1002380/soturonn/README.md

# 卒業論文
 [本文](https://github.com/1002380/soturonn/blob/main/%E8%B3%87%E6%96%99/%E6%9C%AC%E7%A8%BF_%E7%B4%B0%E5%B7%9D%E8%92%BC%E7%94%9F.pdf)
 
 [作成したプログラム](https://github.com/1002380/soturonn/blob/main/%E8%B3%87%E6%96%99/ble_thermo.ino)

 進捗報告書
  - 目次
    - [progress01](https://github.com/1002380/soturonn/blob/main/%E8%B3%87%E6%96%99/progress01.md) アップロードのテスト
    - [progress02](https://github.com/1002380/soturonn/blob/main/%E8%B3%87%E6%96%99/progress02.md) 春休みまでに考えていたことのまとめ
    - [progress03](https://github.com/1002380/soturonn/blob/main/%E8%B3%87%E6%96%99/progress03.md) 研究内容の整理
    - [progress04](https://github.com/1002380/soturonn/blob/main/%E8%B3%87%E6%96%99/progress04.md) 電波から電気を取り出す練習
    - [progress05](https://github.com/1002380/soturonn/blob/main/%E8%B3%87%E6%96%99/progress05.md) 平滑回路の実験
    - [progress06](https://github.com/1002380/soturonn/blob/main/%E8%B3%87%E6%96%99/progress06.md) LEDの点灯実験
    - [progress07](https://github.com/1002380/soturonn/blob/main/%E8%B3%87%E6%96%99/progress07.md) 安定化回路の作成
    - [progress08](https://github.com/1002380/soturonn/blob/main/%E8%B3%87%E6%96%99/progress08.md) 変圧回路の実験
    - [progress09](https://github.com/1002380/soturonn/blob/main/%E8%B3%87%E6%96%99/progress09.md) オシロスコープの影響の調査
    - [progress10](https://github.com/1002380/soturonn/blob/main/%E8%B3%87%E6%96%99/progress10.md) アンテナの設計
    - [progress11](https://github.com/1002380/soturonn/blob/main/%E8%B3%87%E6%96%99/progress11.md) アンテナの作成実験 
    - [progress12](https://github.com/1002380/soturonn/blob/main/%E8%B3%87%E6%96%99/progress12.md) 複数巻きループアンテナの実験
    - [progress13](https://github.com/1002380/soturonn/blob/main/%E8%B3%87%E6%96%99/progress13.md) ラジオ用アンテナの実験
    - [progress14](https://github.com/1002380/soturonn/blob/main/%E8%B3%87%E6%96%99/progress14.md) ダイポールアンテナの実験
    - [progress15](https://github.com/1002380/soturonn/blob/main/%E8%B3%87%E6%96%99/progress15.md) AMラジオ塔での実験
    - [progress16](https://github.com/1002380/soturonn/blob/main/%E8%B3%87%E6%96%99/progress16.md) 充電用回路の改造
    - [progress17](https://github.com/1002380/soturonn/blob/main/%E8%B3%87%E6%96%99/progress17.md) 機材の注文
    - [progress18](https://github.com/1002380/soturonn/blob/main/%E8%B3%87%E6%96%99/progress18.md) 電磁波によるバッテリ充電
    - [progress19](https://github.com/1002380/soturonn/blob/main/%E8%B3%87%E6%96%99/progress19.md) 作る電子機器の構想
    - [progress20](https://github.com/1002380/soturonn/blob/main/%E8%B3%87%E6%96%99/progress20.md) アンテナの改良
    - [progress21](https://github.com/1002380/soturonn/blob/main/%E8%B3%87%E6%96%99/progress21.md) 電子機器の開発
    - [progress22](https://github.com/1002380/soturonn/blob/main/%E8%B3%87%E6%96%99/progress22.md) ディープスリープモードの実装
    - [progress23](https://github.com/1002380/soturonn/blob/main/%E8%B3%87%E6%96%99/progress23.md) データ保存の実装
    - [progress24](https://github.com/1002380/soturonn/blob/main/%E8%B3%87%E6%96%99/progress24.md) プログラムの修正
