1002380/soturonn/資料/README.md

# 卒業論文
 本文(https://github.com/1002380/soturonn/資料/本稿_細川蒼生.pdf)

 作成したプログラム(https://github.com/1002380/soturonn/資料/ble_thermo.ino)

 進捗報告書
  - 目次
    - progress01(https://github.com/1002380/soturonn/資料/progress01.md) アップロードのテスト
    - progress02(https://github.com/1002380/soturonn/資料/progress02.md) 春休みまでに考えていたことのまとめ
    - progress03(https://github.com/1002380/soturonn/資料/progress03.md) 研究内容の整理
    - progress04(https://github.com/1002380/soturonn/資料/progress04.md) 電波から電気を取り出す練習
    - progress05(https://github.com/1002380/soturonn/資料/progress05.md) 平滑回路の実験
    - progress06(https://github.com/1002380/soturonn/資料/progress06.md) LEDの点灯実験
    - progress07(https://github.com/1002380/soturonn/資料/progress07.md) 安定化回路の作成
    - progress08(https://github.com/1002380/soturonn/資料/progress08.md) 変圧回路の実験
    - progress09(https://github.com/1002380/soturonn/資料/progress09.md) オシロスコープの影響の調査
    - progress10(https://github.com/1002380/soturonn/資料/progress10.md) アンテナの設計
    - progress11(https://github.com/1002380/soturonn/資料/progress11.md) アンテナの作成実験 
    - progress12(https://github.com/1002380/soturonn/資料/progress12.md) 複数巻きループアンテナの実験
    - progress13(https://github.com/1002380/soturonn/資料/progress13.md) ラジオ用アンテナの実験
    - progress04(https://github.com/1002380/soturonn/資料/progress04.md) 電波から電気を取り出す練習
    - progress05(https://github.com/1002380/soturonn/資料/progress05.md) 平滑回路の実験
    - progress06(https://github.com/1002380/soturonn/資料/progress06.md) LEDの点灯実験
    - progress07(https://github.com/1002380/soturonn/資料/progress07.md) 安定化回路の作成
    - progress08(https://github.com/1002380/soturonn/資料/progress08.md) 変圧回路の実験
    - progress09(https://github.com/1002380/soturonn/資料/progress09.md) オシロスコープの影響の調査
    - progress10(https://github.com/1002380/soturonn/資料/progress10.md) アンテナの設計
    - progress11(https://github.com/1002380/soturonn/資料/progress11.md) アンテナの作成実験
    - progress12(https://github.com/1002380/soturonn/資料/progress12.md) 複数巻きループアンテナの実験
    - progress13(https://github.com/1002380/soturonn/資料/progress13.md) ラジオ用アンテナの実験
    - progress14(https://github.com/1002380/soturonn/資料/progress13.md) ラジオ用アンテナの実験
