1002380/soturonn/資料/progress11.md

# 進捗報告書

報告書番号 | 氏名   | 期間         | 報告日
----- | ---- | ---------- | ---
11    | HosokawaAoi | 6/7 ~ 6/28 | 6/28

## 活動概要

- やったこと
  - 1回巻きループアンテナ、ダイポールアンテナの作成
  - ループアンテナと検波回路の実験
  - 測定位置による電圧の変化の調査
  - ダイポールアンテナによる実験
<br />

### アンテナの作成
  - 今回は1回巻きループアンテナとダイポールアンテナを作成した。
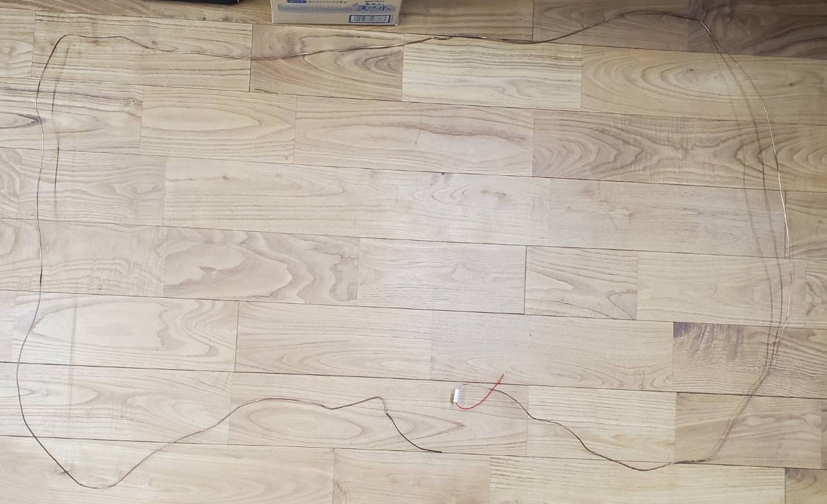
[picture p153: 資料/画像/画像11/画像11_1.jpg]
画像1
  - 
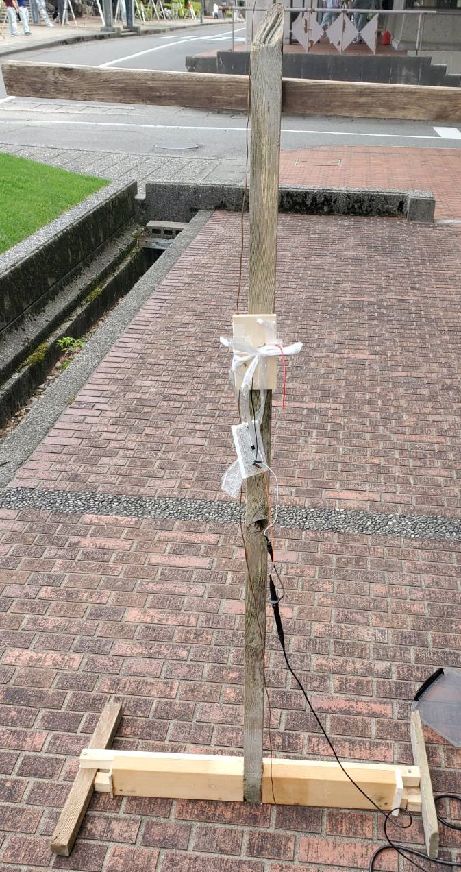
[picture p154: 資料/画像/画像11/画像11_16.jpg]
画像16
  - 
  - 回路
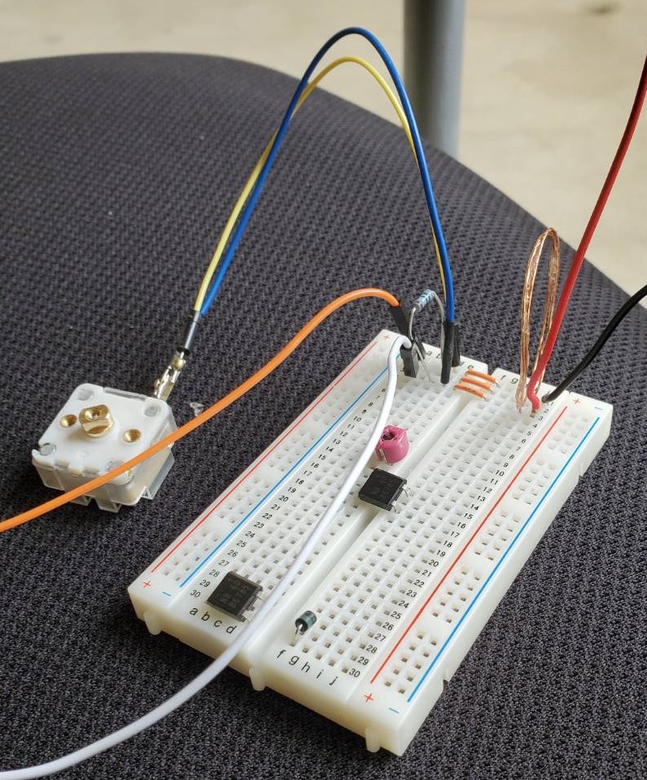
[picture p155: 資料/画像/画像11/画像11_2.jpg]
画像2
  - 
  - 今回の実験では途中まで洋服掛けをアンテナの台座として使用したが、今後のことも考慮して専用の台座を作成した。
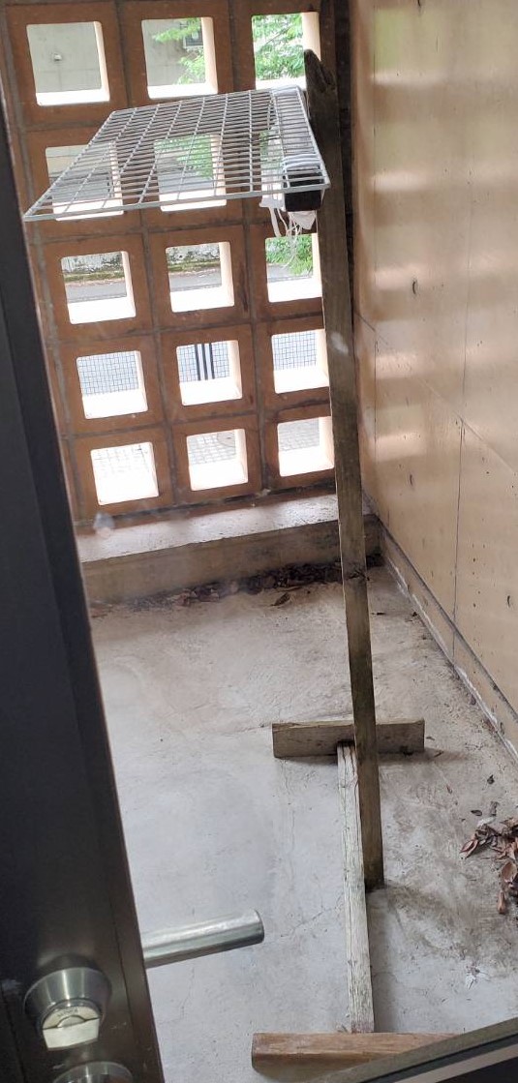
[picture p156: 資料/画像/画像11/画像11_3.jpg]
画像3
  - 

### 検波回路の実験
- 研究室での実験
  - 可変容量コンデンサの静電容量を最小の状態から上げていったところ次の波形が確認された。
  - 静電容量が最小の状態
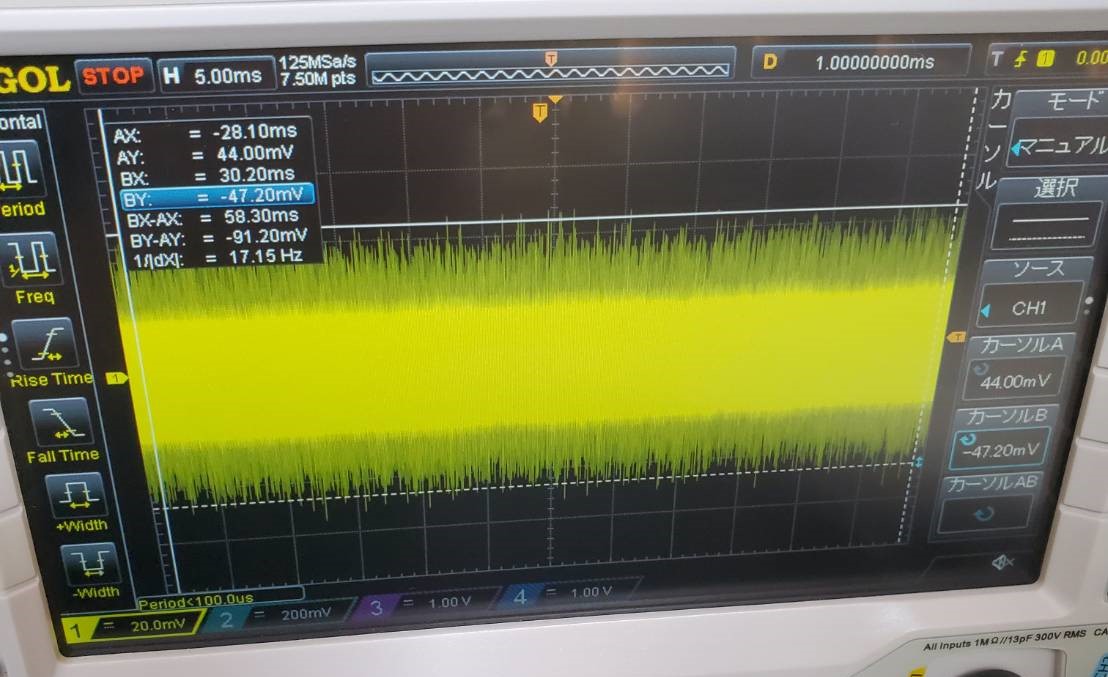
[picture p157: 資料/画像/画像11/画像11_4.jpg]
画像4
  - 
  - +-45mV
  - 電圧が最大となった状態
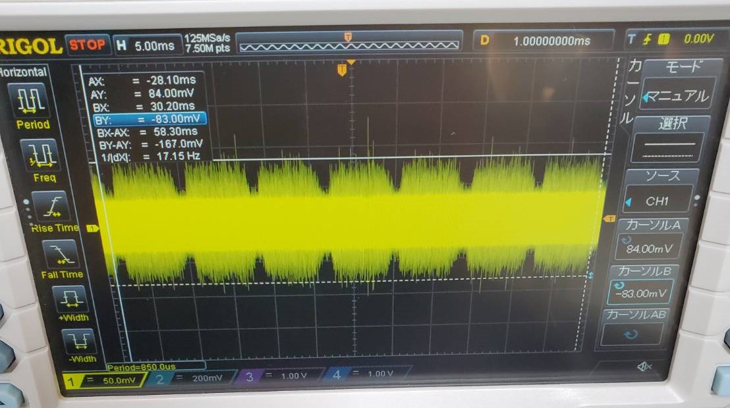
[picture p158: 資料/画像/画像11/画像11_5.jpg]
画像5
  - 
  - +-80mV
  - 電圧が最小となった状態
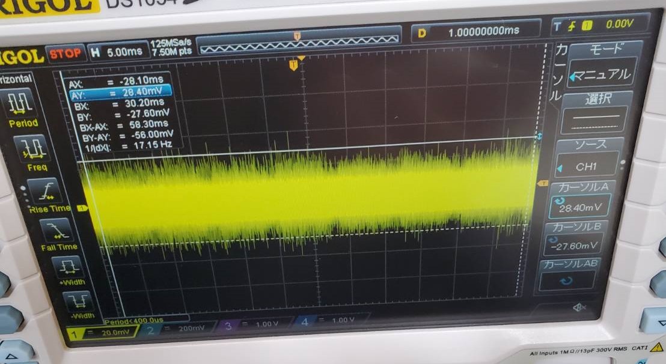
[picture p159: 資料/画像/画像11/画像11_6.jpg]
画像6
  - 
  - +-30mV
  - 電圧が最小からやや増えた状態
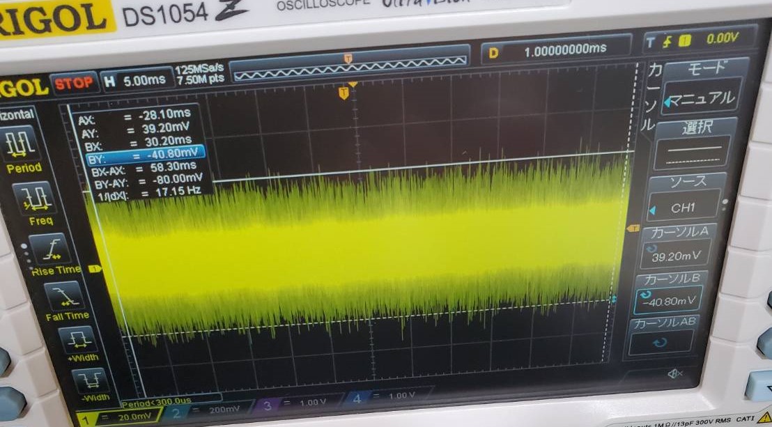
[picture p160: 資料/画像/画像11/画像11_7.jpg]
画像7
  - 
  - +-40mV
  - 静電容量が最大の状態
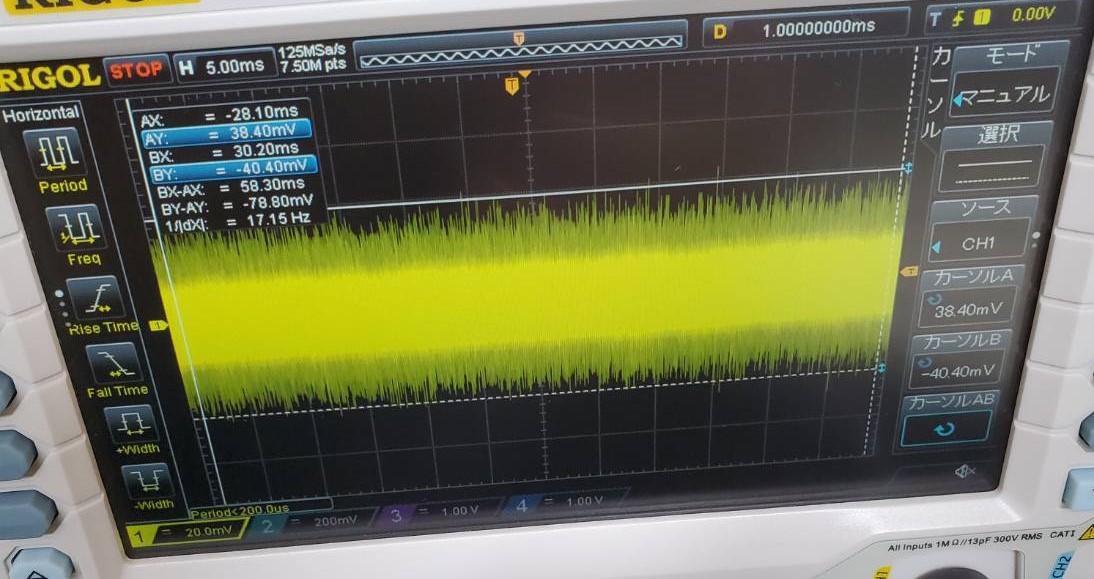
[picture p161: 資料/画像/画像11/画像11_8.jpg]
画像8
  - 
  - +-40mV
  - コンデンサの静電容量次第で電圧が60mV程度変化することが分かった。
  - 静電容量に電圧(抵抗値)が反比例していないので、恐らく共振に抵抗の変化も生じていると考えられる。(静電容量の抵抗値は1/(2π*周波数*静電容量))
  - 検波回路のコンデンサは5pFから20pFまで静電容量を変更可能であり、10pFで目的のラジオ局の電波と共振するように検波回路を作成したので、電圧が最大になった状態が、利用するラジオ局の電波であると予想する
  
- 屋外での実験
  - 研究室の実験と同様に静電容量を徐々に上げていった。
  - 静電容量が最小の状態
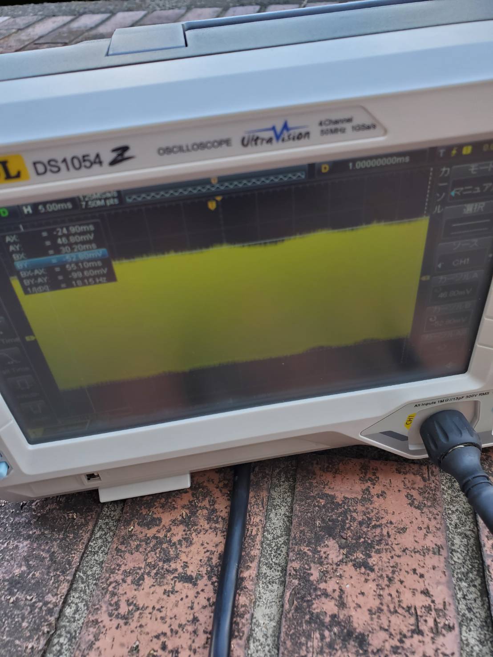
[picture p162: 資料/画像/画像11/画像11_27.jpg]
画像27
  - 
  - +-50mV
  - 電圧が最大となった状態
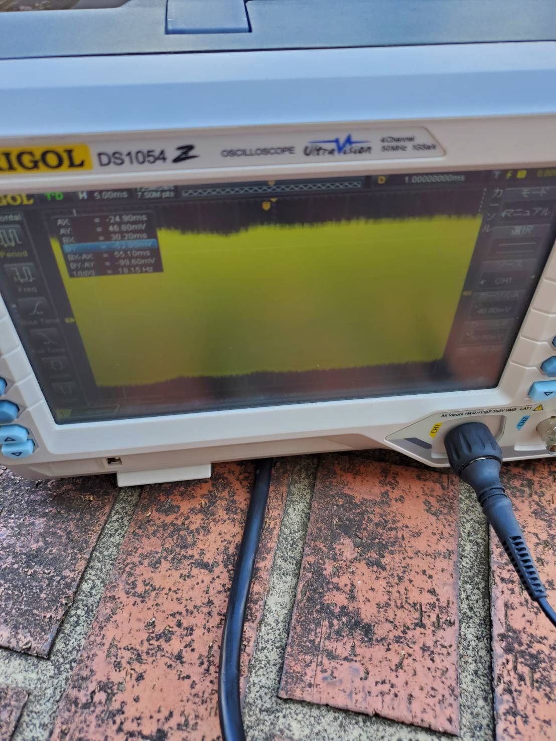
[picture p163: 資料/画像/画像11/画像11_28.jpg]
画像28
  - 
  - +-80mV
  - 電圧が最小となった状態
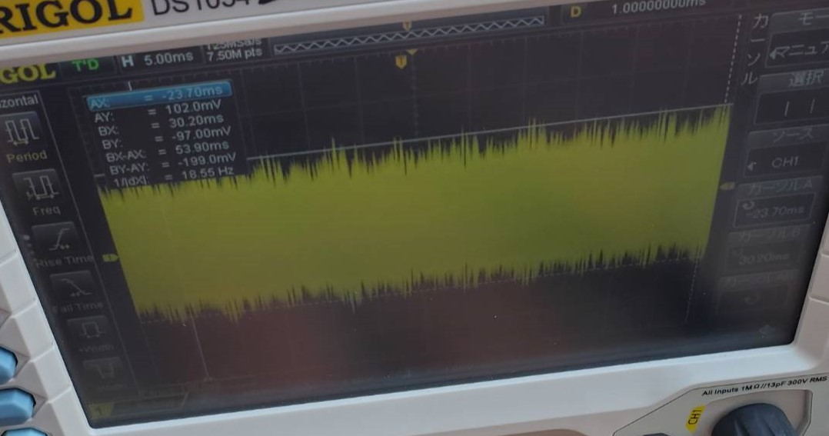
[picture p164: 資料/画像/画像11/画像11_28.5.jpg]
画像28.5
  - 
  - +-25mV
  - 電圧が最小からやや増えた状態
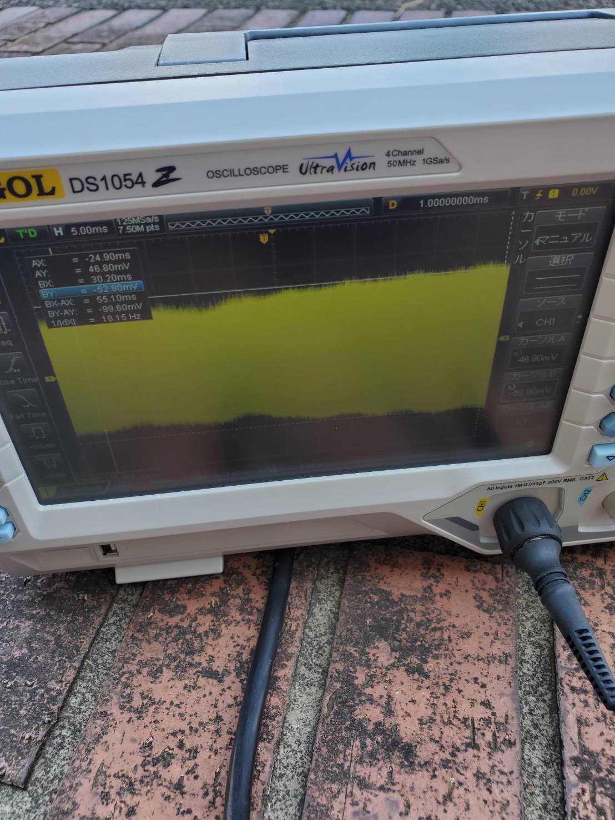
[picture p165: 資料/画像/画像11/画像11_29.jpg]
画像29
  - 
  - +-50mV
  - 静電容量が最大の状態
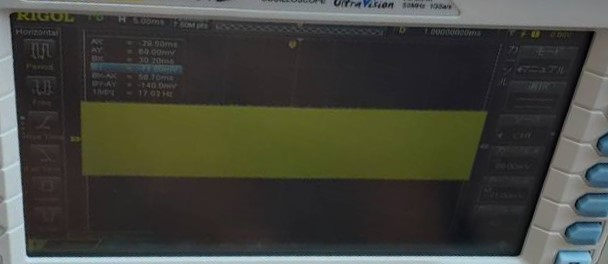
[picture p166: 資料/画像/画像11/画像11_30.jpg]
画像30
  - 
  - +-65mV
  - 実験室内の記録との比較
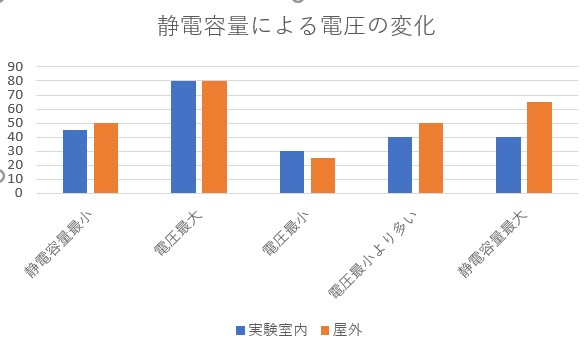
[picture p167: 資料/画像/画像11/グラフ11_1.jpg]
グラフ1
  - 
  - 研究室での結果と比較すると全体的に得られる電圧の増減のしかたや最大値と最小値に大きな差はない。
  - しかし波形を比べると屋外の方が測定値とした値を出す頻度が高く時間あたりの平均値なら高くなっていると考えられる。
  - 2種類の場所で近い静電容量の時に電圧が最大になることから利用するラジオ局の電波であると考えられる。
  - 以降の実験では測定場所が同じもしくは近い場所で既に検波回路の実験を終えている場合、検波回路は排除して実験する。

### 測定位置による電圧の変化の調査
  - 1回巻きループアンテナの検波回路を除いた状態で設置場所を変更して実験した。
  - 研究室
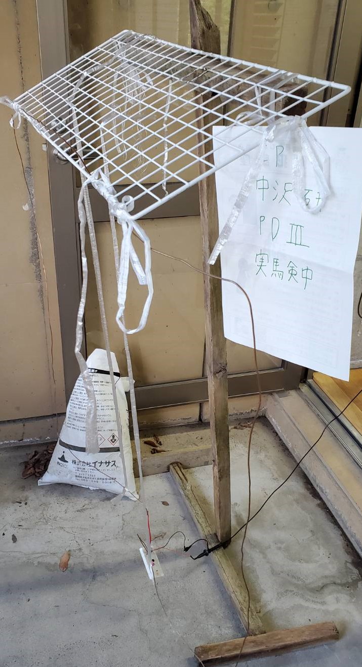
[picture p168: 資料/画像/画像11/画像11_17.jpg]
画像17
  - 
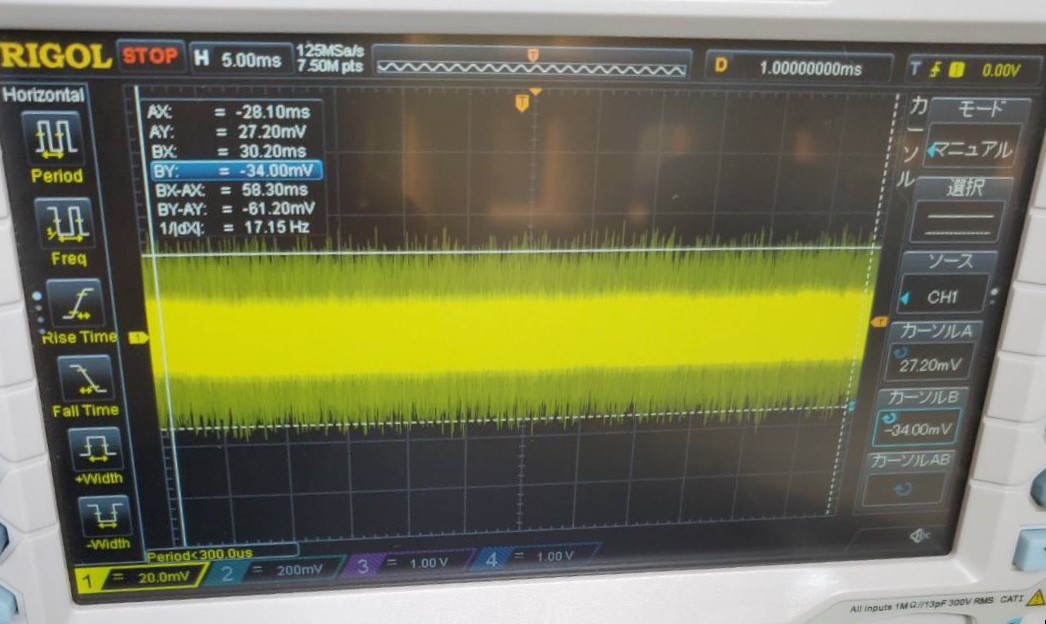
[picture p169: 資料/画像/画像11/画像11_10.jpg]
画像10
  - 
  - +-30mV
  - 地点A(屋外での検波回路の実験を行った場所)
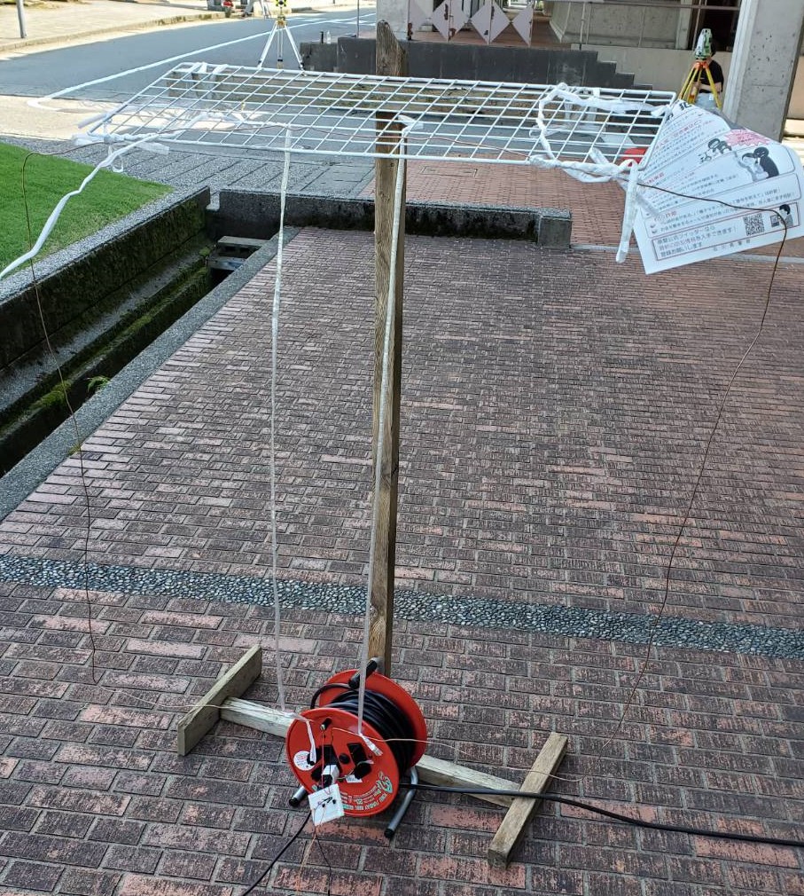
[picture p170: 資料/画像/画像11/画像11_19.jpg]
画像19
  - 
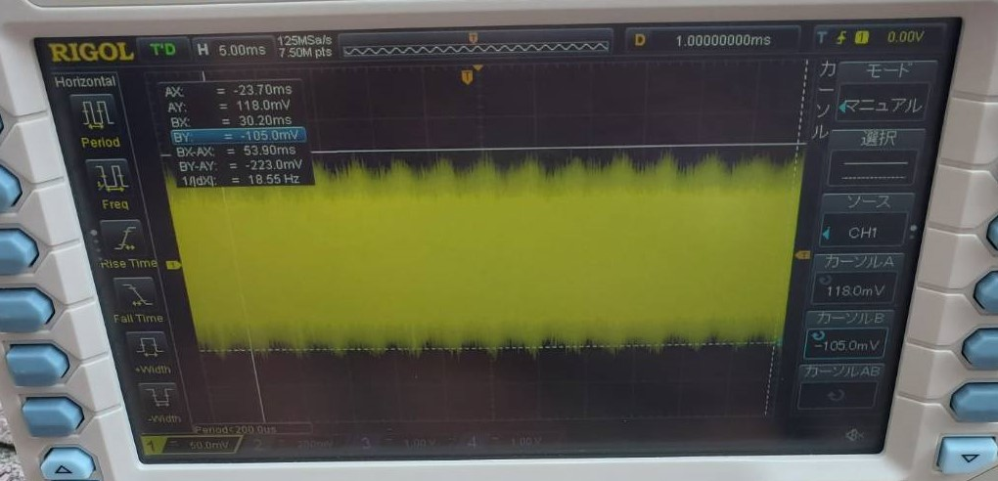
[picture p171: 資料/画像/画像11/画像11_20.jpg]
画像20
  - 
  - +-110mV
  - 地点B(地点Aよりアンテナに近い)
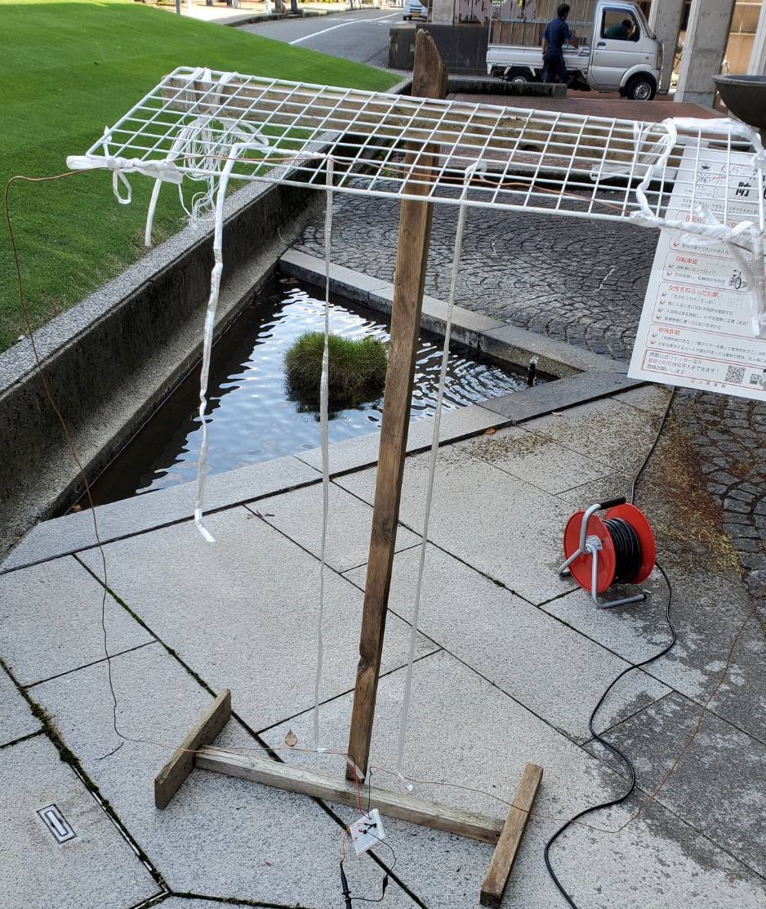
[picture p172: 資料/画像/画像11/画像11_21.jpg]
画像21
  - 
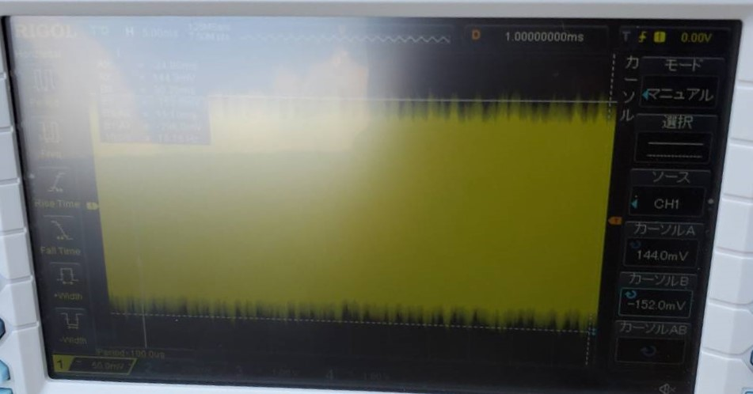
[picture p173: 資料/画像/画像11/画像11_22.jpg]
画像22
  - 
  - +-145mV
  - 地点C(地点Bよりアンテナに近い)
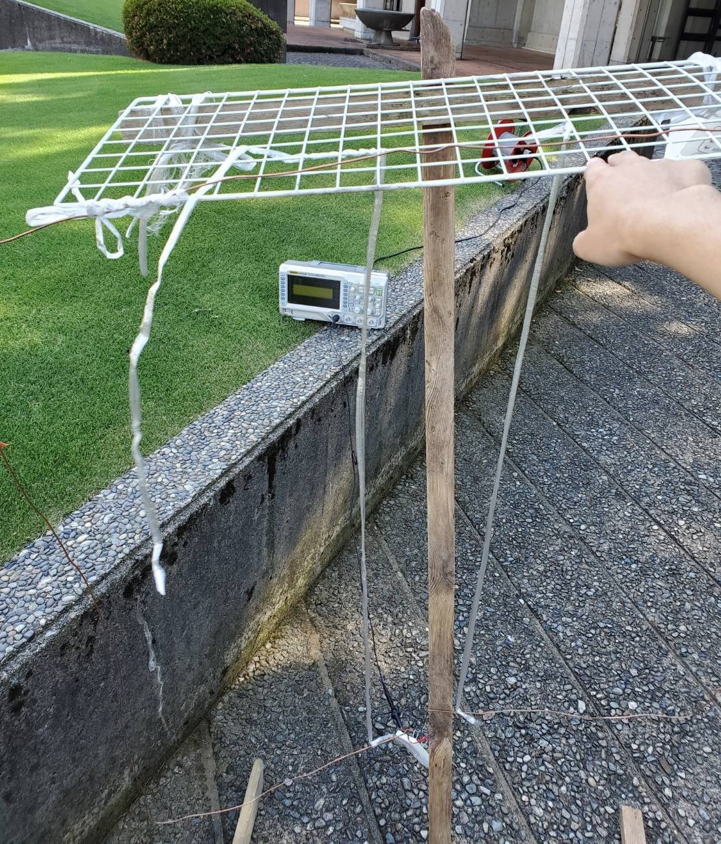
[picture p174: 資料/画像/画像11/画像11_23.jpg]
画像23
  - 
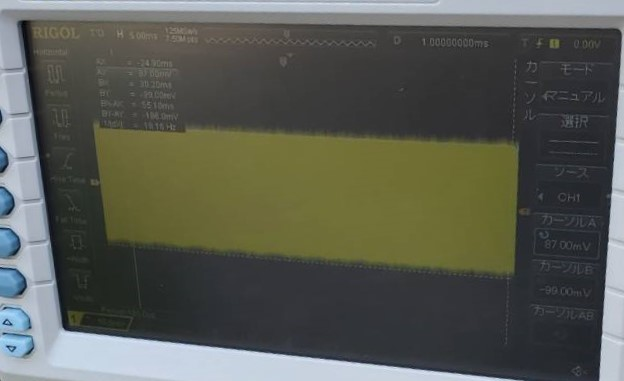
[picture p175: 資料/画像/画像11/画像11_24.jpg]
画像24
  - 
  - +-90mV
  - 電波の発生元に近づく程電圧は上がったが近づけすぎると減少した。
  - しかしループアンテナの高さを調整すると電圧は上がった。これ程の変化は他の地点では見られなかった。
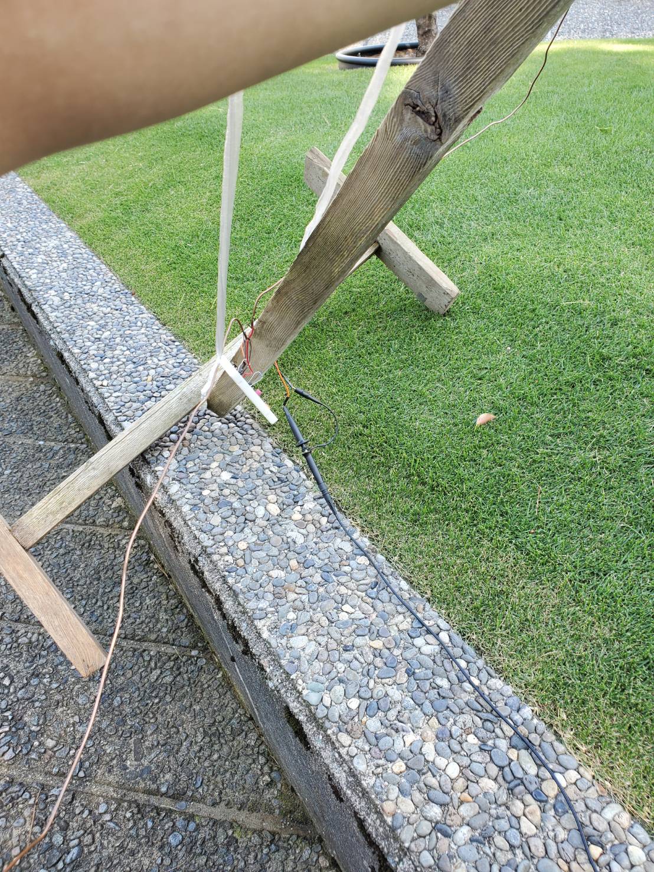
[picture p176: 資料/画像/画像11/画像11_25.jpg]
画像25
  - 
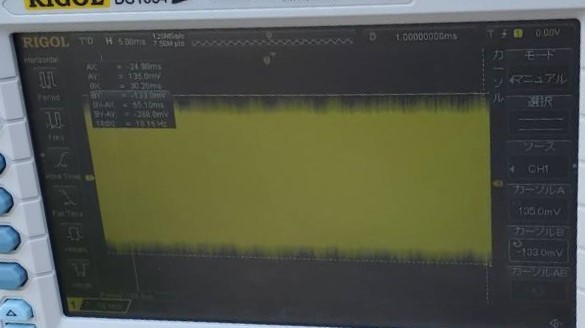
[picture p177: 資料/画像/画像11/画像11_26.jpg]
画像26
  - 
  - +-135mV
  - 恐らく電波の発生元がLCの屋上なので近づけすぎるとLCが障害物になって電波が届きにくくなっているか石の壁が邪魔していると考えられる。
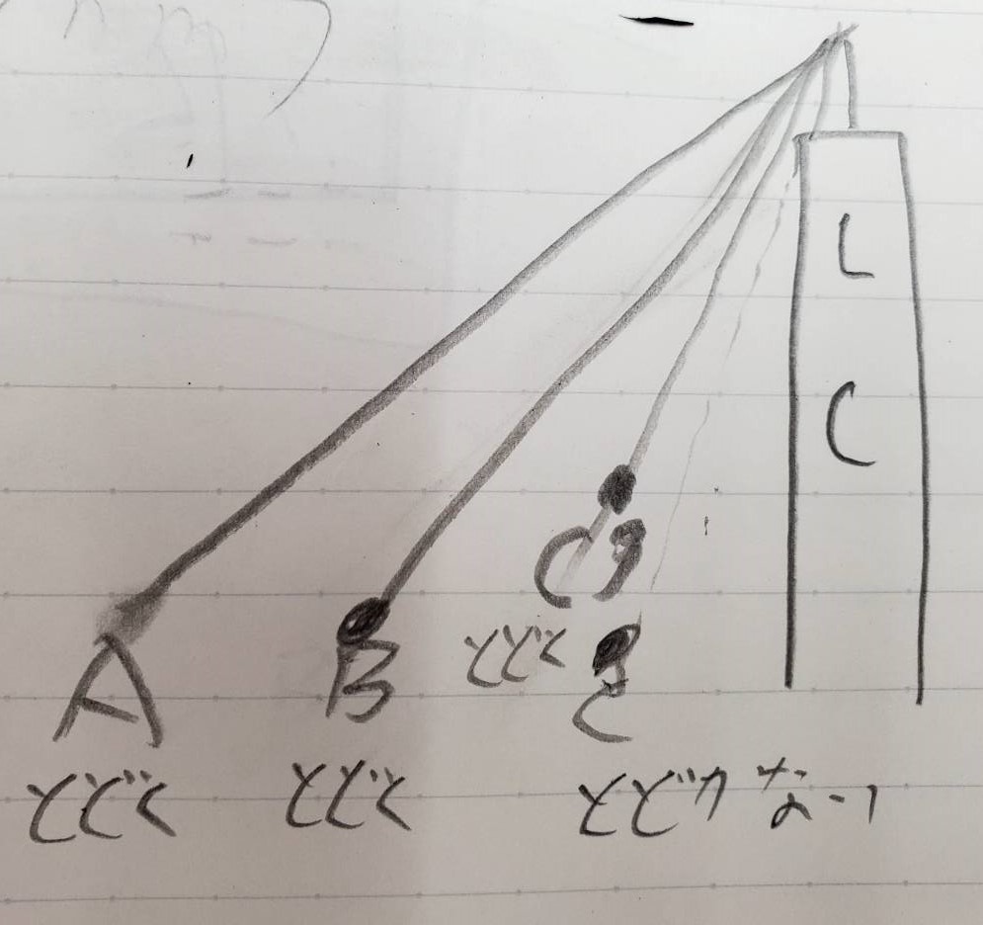
[picture p178: 資料/画像/画像11/画像11_15.jpg]
画像15
  - 
<br />

### ダイポールアンテナによる実験
  - 地点ABCはループアンテナの実験の時と同様の場所である。
  - 研究室
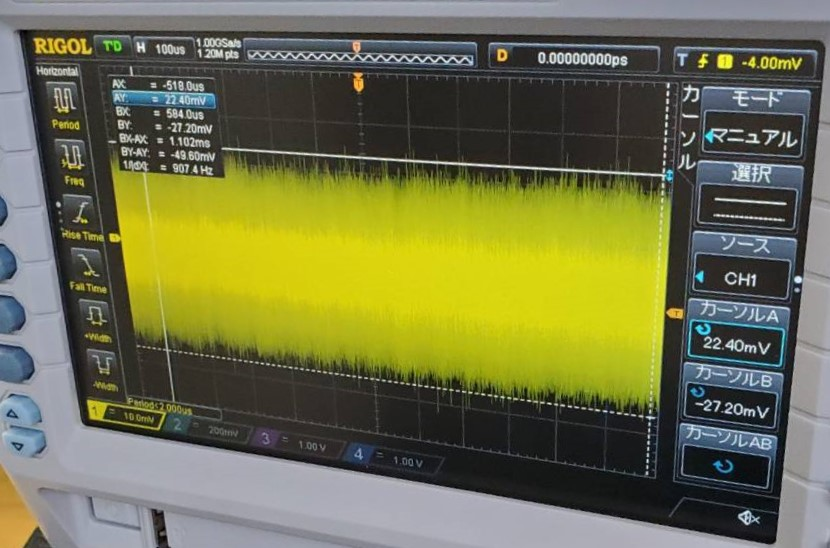
[picture p179: 資料/画像/画像11/画像11_18.jpg]
画像18
  - 
  - +-25mV
  - 地点A
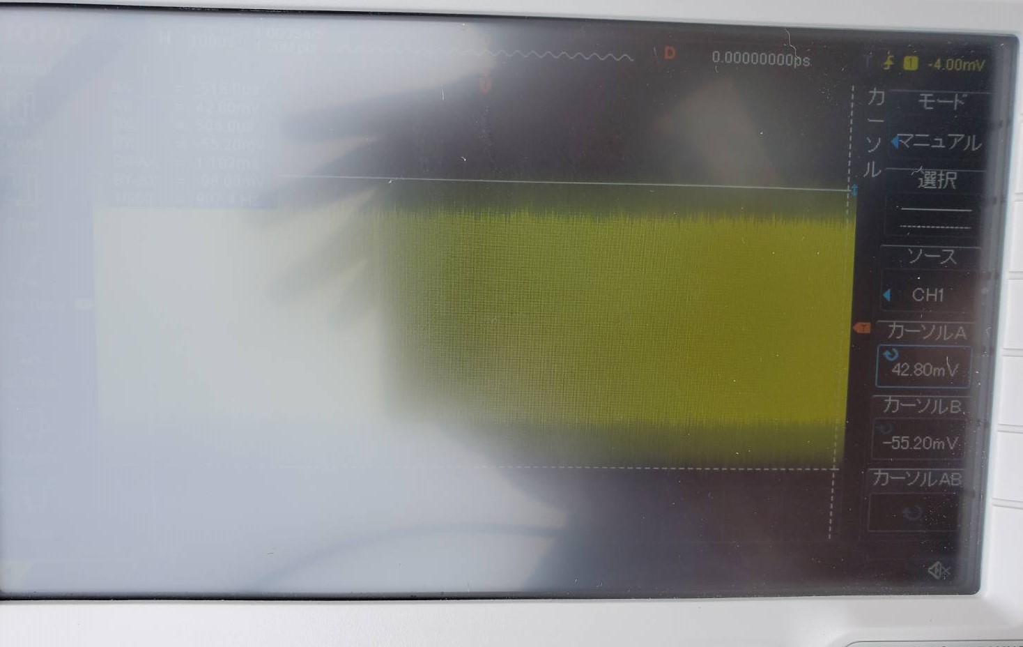
[picture p180: 資料/画像/画像11/画像11_11.jpg]
画像11
  - 
  - +-50mV
  - 地点B
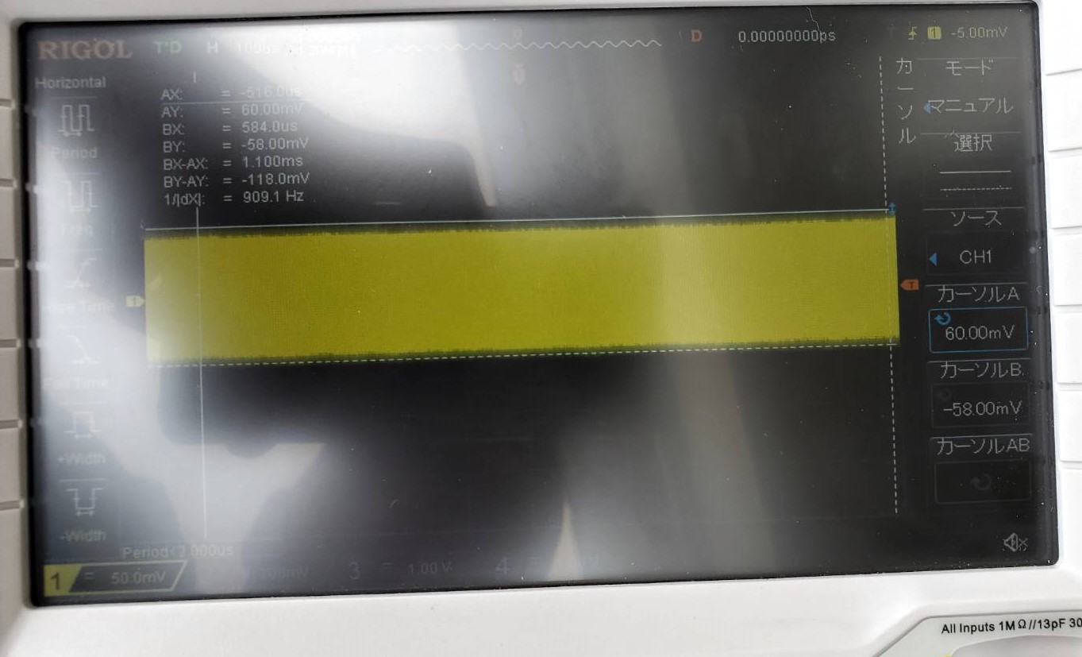
[picture p181: 資料/画像/画像11/画像11_12.jpg]
画像12
  - 
  - +-60mV
  - 地点C
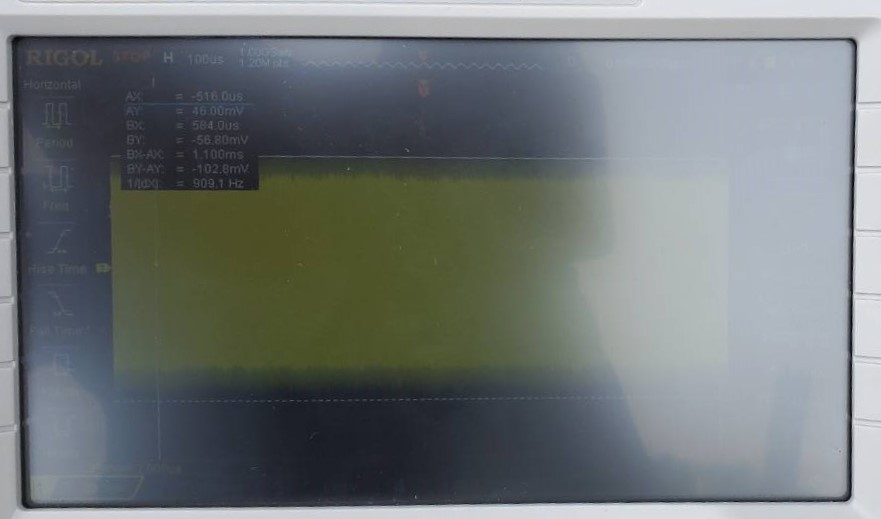
[picture p182: 資料/画像/画像11/画像11_13.jpg]
画像13
  - 
  - +-55mV
  - 地点C(高さ調整)
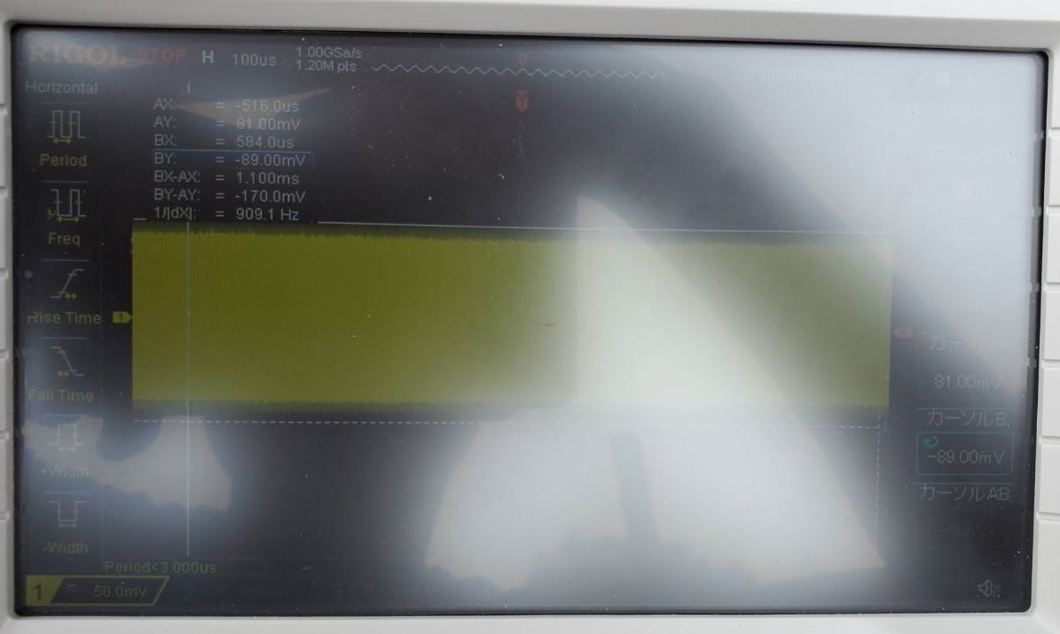
[picture p183: 資料/画像/画像11/画像11_14.jpg]
画像14
  - 
  - +-85mV
  - 1回巻きループアンテナとの比較
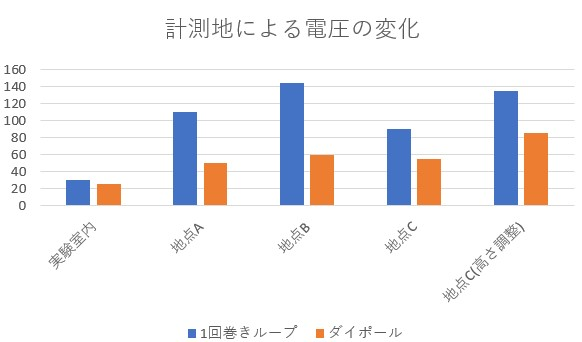
[picture p184: 資料/画像/画像11/グラフ11_2.jpg]
グラフ2
  - 
  - あまり高い電圧は得られなかった
  - 帯域幅が狭いアンテナなので、精度の悪さが影響していると考えられる。
  - 体積や使用する銅線の量(ループアンテナの1/2)的には優れている。

<br />

## 活動予定
- 現状の整理
  - 電波をマイコンの電源にしたい。
  - 5V1Aを安定して出力する電源を作成する。
  - 電流は置いておいて、まず一定の電圧を出力し続ける回路を作成する。
  - 電波を直流に変換できたが、電圧を安定させるための安定化回路が動作しない。
  - 実はそれ以外の回路も正しく動いてなかった。(現状の課題)

- 課題への対策
  - 無駄な電圧を電流に変圧回路で変換する。(終了)
  - 整流回路を変える。(回路作成のみ終了)
  - アンテナの数や種類を変える。(実行中)

- 使いたいアンテナ
  - 1回巻きループアンテナ(作成済み、実験終了)
  - 複数巻きループアンテナ(次回作成)
  - ダイポールアンテナ (作成済み、実験終了)
  - ラジオのアンテナ
  - 既製品のアンテナ

- 電波法について
  - よく分からないので弁護士とか電気電子の教員に相談することにした
  - 金沢市が運営する無料法律相談所を利用予定
  - 予約が取れ次第行く
  - 電気電子の教員については現在探している途中(野口)

- コンセントの使用許可について
  - アンテナとそれを取り付ける台座を作成し、共振回路によって周波数に応じて得られる電気が異なることが確認できた。
  - しかし得られた電気はとても少ないので、アンテナの設置場所を変更して実験を行いたい。
  - 電圧の波形を測定するオシロスコープを研究室外(特に屋外)で使うにはその場所とその場所のコンセントの使用許可を取らなければならない。
  - 希望する設置場所:LC周辺(画像は6号館の外)
  - 画像9 
  - 希望する日程:次の金曜日か月曜日
  - 希望する時間:14:00~15:30(設置、片付け込み)
  - 使用する機器:リールコード、オシロスコープ
  - 消費電力:50W

- メモ
  - 給電用の電波局も作ってはどうか

- 研究活動 
- 振り返り事項

## 研究室に来る日程と時間帯

月             | 火             | 水             | 木             | 金             | 土
------------- | ------------- | ------------- | ------------- | ------------- | -------------
10:00 ~ 12:00 | 10:00 ~ 12:00 | 10:00 ~ 12:00 | 10:00 ~ 12:00 | 10:00 ~ 12:00 | 10:00 ~ 12:00
