1002380/soturonn/資料/progress06.md

# 進捗報告書

報告書番号 | 氏名   | 期間         | 報告日
----- | ---- | ---------- | ---
03    | HosokawaAoi | 4/26 ~ 5/10 | 5/10

## 活動概要

- やったこと
  - 回路構成による電圧の変化
  - ブリッジ回路の調査
  - LEDを点灯させる

- 回路構成による電圧の変化
  - 2つのアンテナを接続する場合にどのような繋ぎ方が効率的なのかを調べるために8パターンの繋ぎ方を試した。
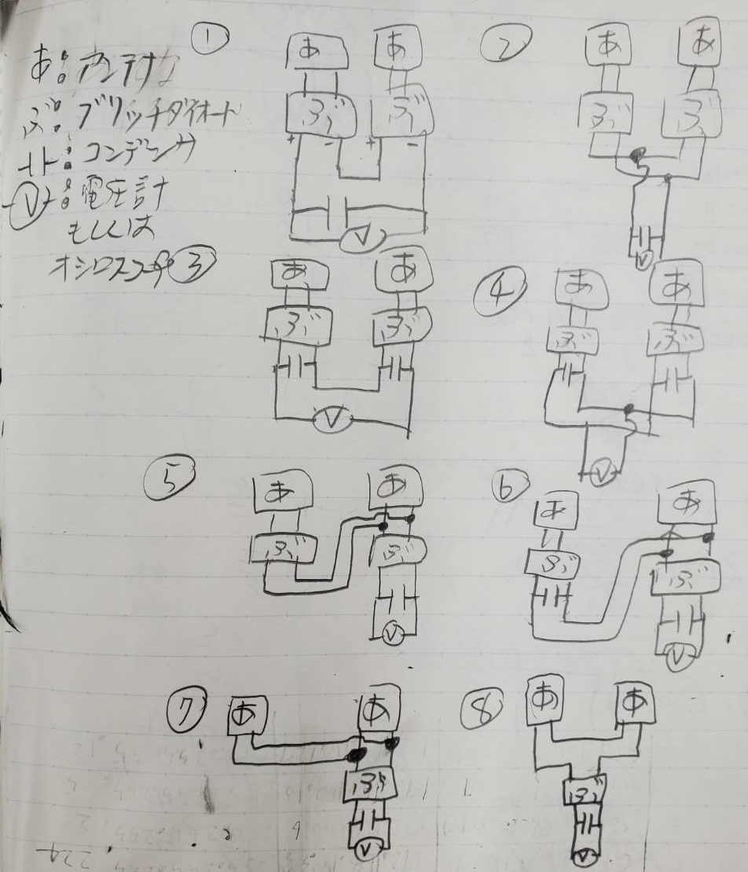
[picture p212: 資料/画像/画像6/画像6_1.jpg]
画像1
  - 
  - それぞれ電圧を測定してみたところ、⑧の繋ぎ方が部品点数も少なく、電圧も高かったので採用することにした。
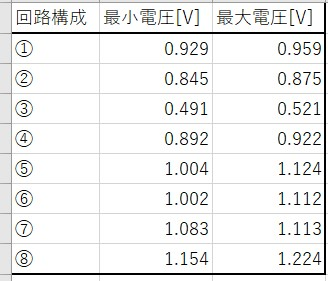
[picture p213: 資料/画像/画像6/表6_1.jpg]
表1
  - 
  - ダイオードは通過すると電圧が少し減るので、ダイオードが少ない方が電圧が高くなったと考えられる。
<br />

- 整流回路の調査
  - 整流回路はアンテナを接続していない状態で平滑化してもプラス方向に偏った出力が確認される。
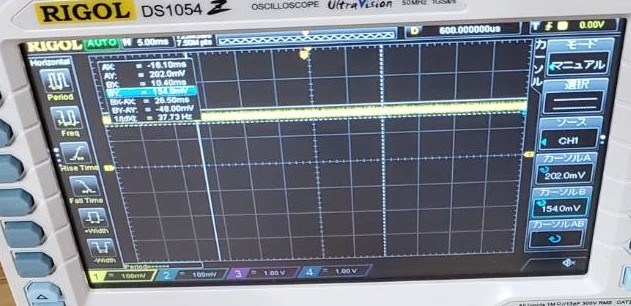
[picture p214: 資料/画像/画像6/画像6_2.jpg]
画像2
  - 
  - しかし整流回路を箱で覆うと出力が0に近づいた。
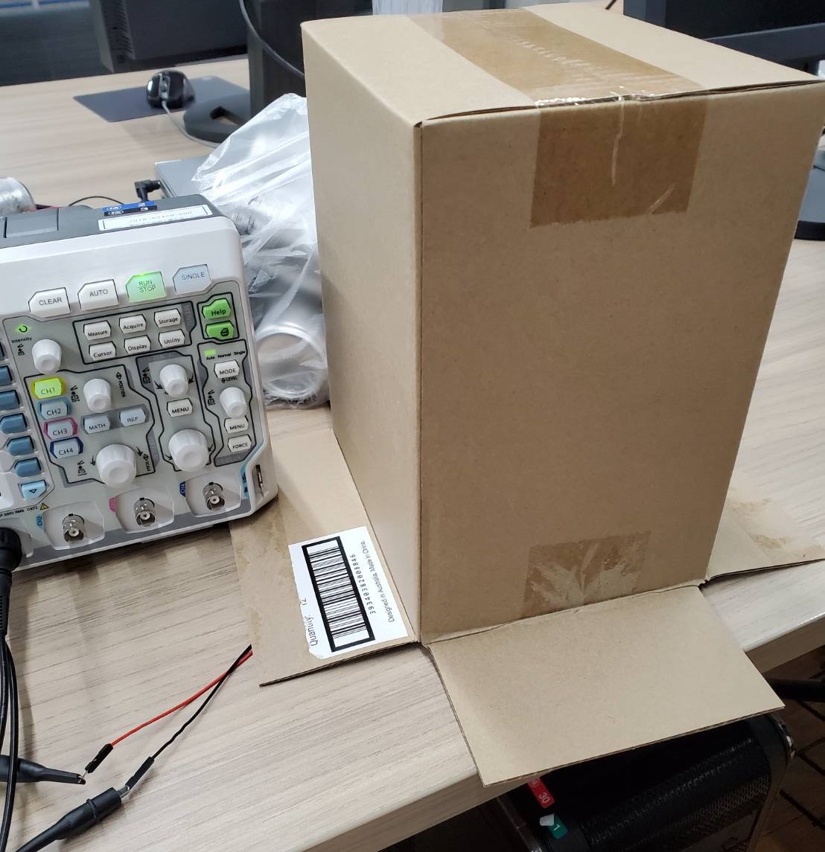
[picture p215: 資料/画像/画像6/画像6_3.jpg]
画像3
  - 
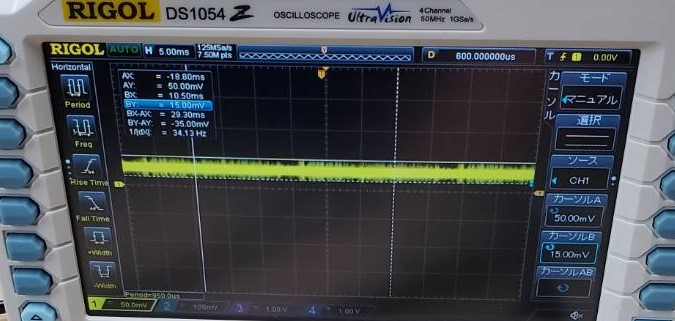
[picture p216: 資料/画像/画像6/画像6_4.jpg]
画像4
  - 
  - これは整流回路に使われている半導体は光を当てることで少し電気を作る作用があるためだと分かった。(参考動画:https://www.youtube.com/watch?v=Er8gqBIJJiw)
  - 以前の実験でもアンテナから得た電気に対し、整流後の出力が高すぎることがあったがこれが原因だと考えられる。
<br />
  
- LEDを点灯させる
  - 採用した回路構成を元にアンテナを増やし、LEDを発光させられるかを調べた。
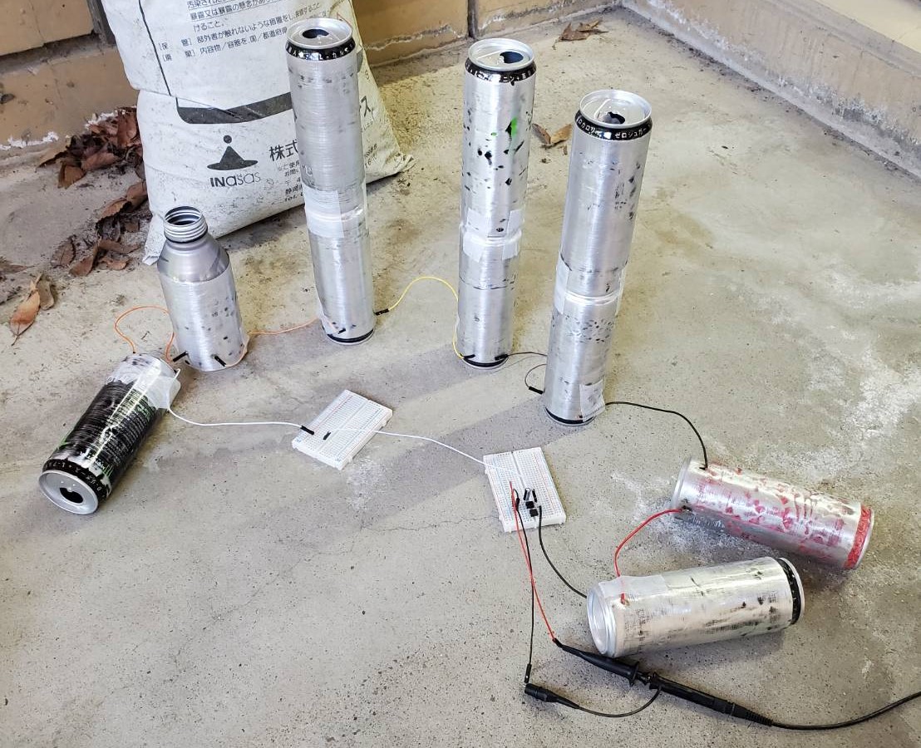
[picture p217: 資料/画像/画像6/画像6_5.jpg]
画像5
  - 
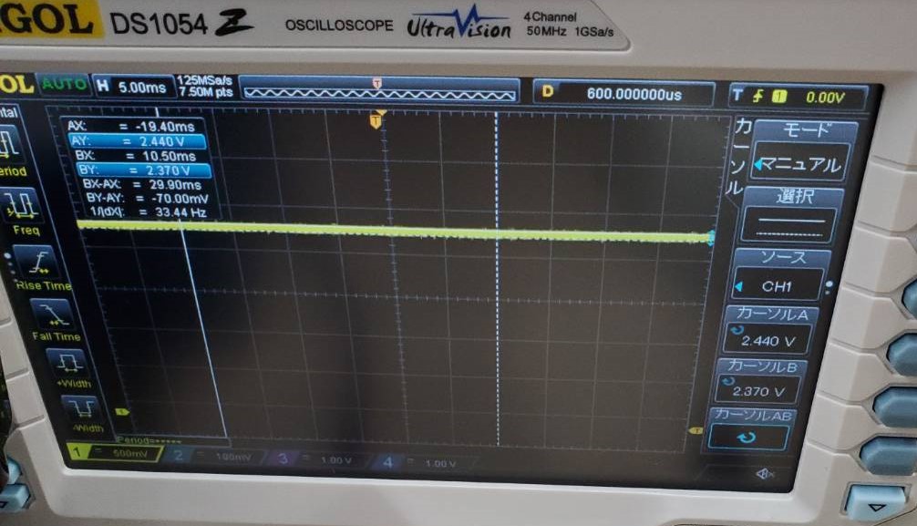
[picture p218: 資料/画像/画像6/画像6_6.jpg]
画像6
  - 
  - 屋外に配置したところ電圧がとても高くなった
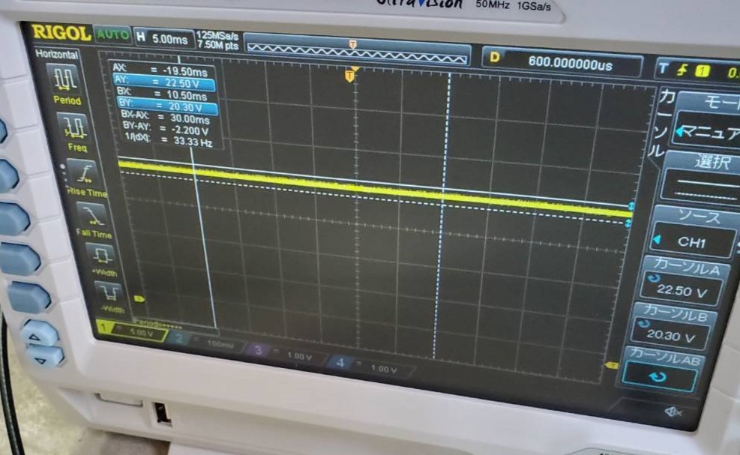
[picture p219: 資料/画像/画像6/画像6_7.jpg]
画像7
  - 
  - 屋外であればLEDを発光させられたが、回路にLEDを接続した一瞬しか光らなかった。
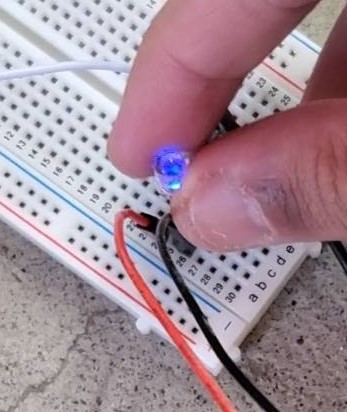
[picture p220: 資料/画像/画像6/画像6_8.jpg]
画像8
  - 
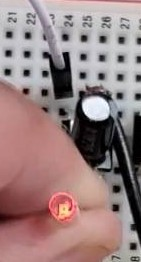
[picture p221: 資料/画像/画像6/画像6_10.jpg]
画像10
  - 
  - 電流についても調べたが、0.2μAと非常に少ない電流しか測定できなかった。
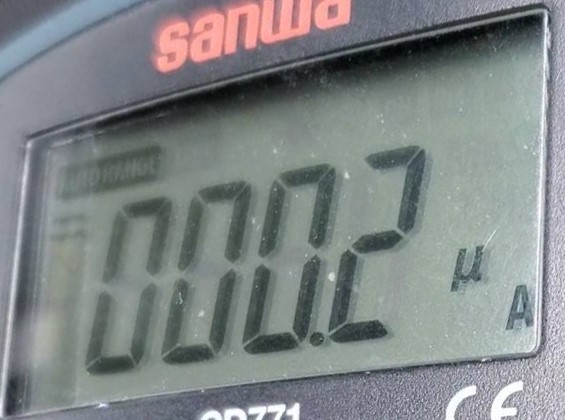
[picture p222: 資料/画像/画像6/画像6_9.jpg]
画像9
  - 
  - 測定できていないだけでLED発光時点ではLEDには数10mAは流れていると推察できる。
  - 前回の電流測定と同様にコンデンサの中身がLED接続時にすぐに無くなるのが原因だと考えられる。
  - 外でなら高い電圧が得られると分かったので安定化回路を設計してみる。
<br />

## 活動予定

- 研究活動 

- 振り返り事項

## 研究室に来る日程と時間帯

月             | 火             | 水             | 木             | 金             | 土
------------- | ------------- | ------------- | ------------- | ------------- | -------------
10:00 ~ 12:00 | 10:00 ~ 12:00 | 10:00 ~ 12:00 | 10:00 ~ 12:00 | 10:00 ~ 12:00 | 10:00 ~ 12:00
