1002380/soturonn/資料/progress02.md

# 進捗報告書

報告書番号 | 氏名   | 期間         | 報告日
----- | ---- | ---------- | ---
01    | HosokawaAoi | 4/4 ~ 4/12 | 4/12

## 活動概要
- 進路
 - 就職希望
 - 書類提出すれば終わり

- 研究概要 環境発電を使ってIoT機器を動かす

- 考えること　
   - 設置場所
   - 電源
   - 通信方法
   - 所得情報

- 設置場所 
  - 電波の届かないとこ → 山 海 空(通信方法をwifiとかに限定するなら屋外全て)
    - 山 保留
    - 海 個人的に興味はある、実験時に毎回海行くのが面倒
    - 空 重力に逆らうのは難しいので没
  - 電気の使えないとこ 電池を使わないなら屋外全て

- 電源 
  - 太陽光:部品は買える、晴れの昼のみ発電可能
  - 電波:低出力、部品を自作する必要がある
  - 電池:買える、有限
  - その他:環境に合わせた発電(振動とか水力とか)

- 通信 
  - zigbeeやLoraWAN:低消費電力、そこそこ離れた距離でも通信できる(リレー形式でもっと遠くに通信できる)
  - ポケットwifi:大体の場所で使えるから本末転倒な気がする、契約が必要
  - *通信方法ごとに異なるマイコン基盤が用意する必要がある

- 取る情報 
  - 電池残量、発電量
  - 適当なセンサの情報 → 気温とかなら確認が容易
  - データサイエンスできそうな情報

- 結局何を調べたいのかが決まってない
- テーマ候補 
  - 環境発電でマイコンを動かす
  - 電波も電気もないとこでIoTを行う
  - IoTを機器を用いたデータサイエンスを行う(データサイエンスの内容は後日検討)

メモ:一瞬ネット繋がる機器

## 活動予定

- 研究活動 
  - テーマの練り直し
  - 作るものの設置場所の決定

- 振り返り事項

  - 反省事項　
  - 今後の活動　

## 研究室に来る日程と時間帯

月             | 火             | 水             | 木             | 金             | 土
------------- | ------------- | ------------- | ------------- | ------------- | -------------
10:00 ~ 12:00 | 10:00 ~ 12:00 | 10:00 ~ 12:00 | 10:00 ~ 12:00 | 10:00 ~ 12:00 | 10:00 ~ 12:00
