1002380/soturonn/資料/progress01.md

# 進捗報告書

報告書番号 | 氏名   | 期間         | 報告日
----- | ---- | ---------- | ---
01    | HosokawaAoi | 4/1 ~ 4/12 | 4/1

## 活動概要

- 研究概要 環境発電を用いて電子機器を動かす

- 進路状況 就職 推薦試験合格済

- その他

## 活動予定

- 研究活動 作りたいものの方針を決める

- 振り返り事項

  - 反省事項　
  - 今後の活動　作るものの資料を作る

## 研究室に来る日程と時間帯

月             | 火             | 水             | 木             | 金             | 土
------------- | ------------- | ------------- | ------------- | ------------- | -------------
10:00 ~ 12:00 | 10:00 ~ 12:00 | 10:00 ~ 12:00 | 10:00 ~ 12:00 | 10:00 ~ 12:00 | 10:00 ~ 12:00
