1002380/soturonn/資料/研究ワークシート発表(最終).pdf

# 環境発電を用いた電子機器の 非電源化の実験

発表者:細川 蒼生

2EP077

## 研究背景

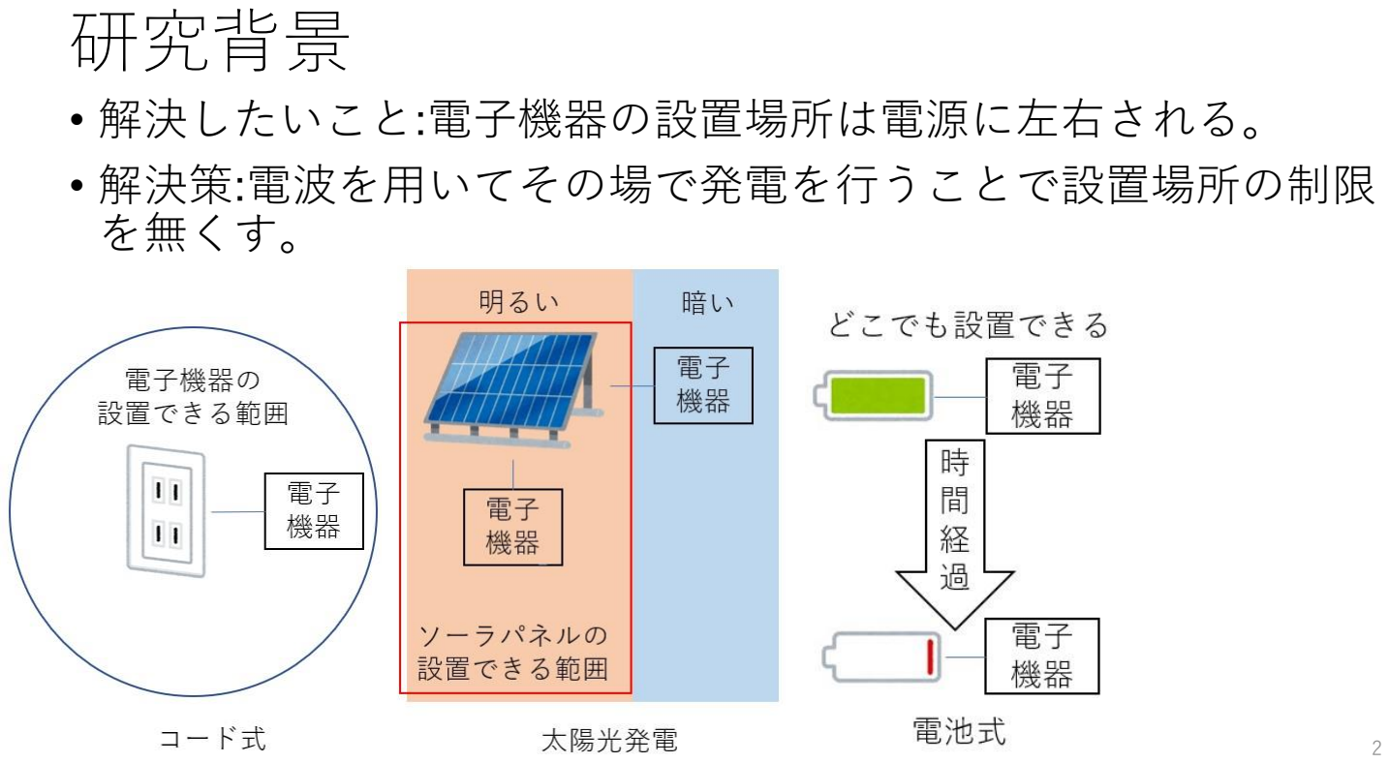
[picture p245: page 2]

- 解決したいこと:電子機器の設置場所は電源に左右される。
- 解決策:電波を用いてその場で発電を行うことで設置場所の制限 を無くす。

## 研究背景

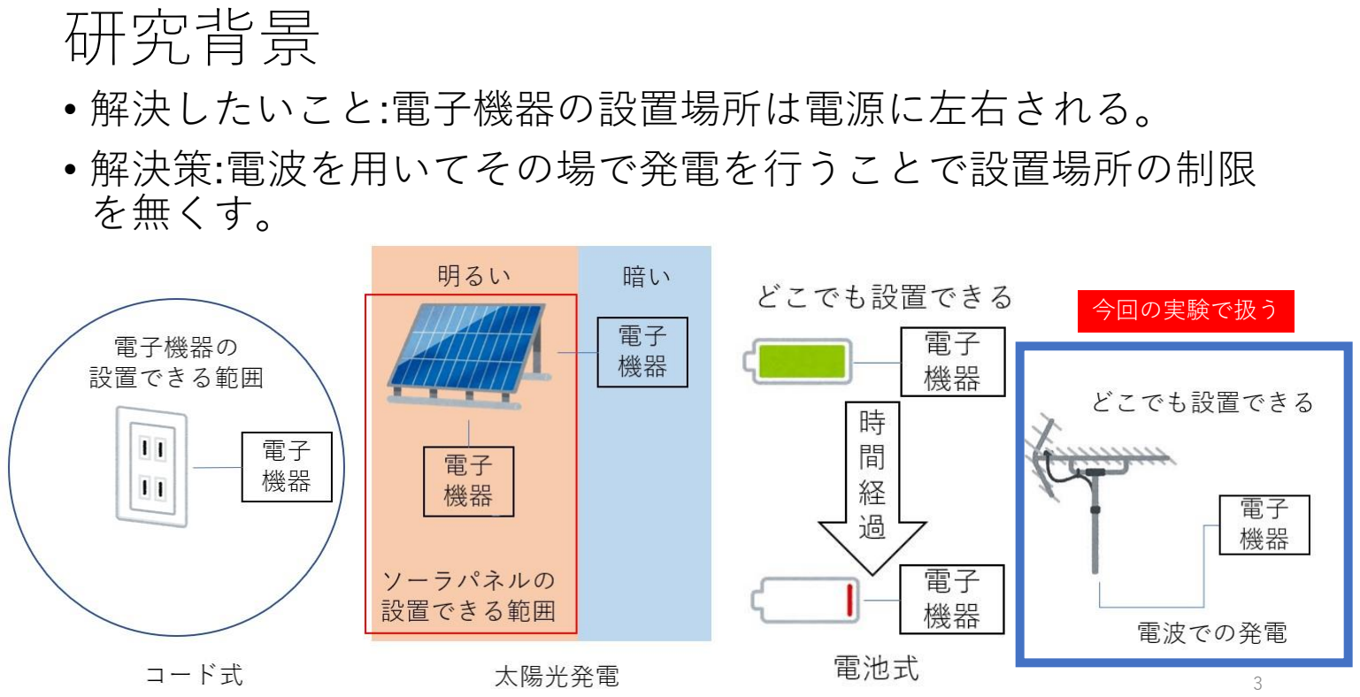
[picture p246: page 3]

- 解決したいこと:電子機器の設置場所は電源に左右される。
- 解決策:電波を用いてその場で発電を行うことで設置場所の制限 を無くす。

今回の実験で扱う

## 実験内容(1/4) 実験場所を探す

- 電波でLEDを発光させることを目標に回路やアンテナを作成した。
- 最初は研究室のベランダで実験したが電波から得られる電力は少 なかったので、実験場所を高出力のAM波を出すラジオ塔付近に 変更するとLEDが発光した。

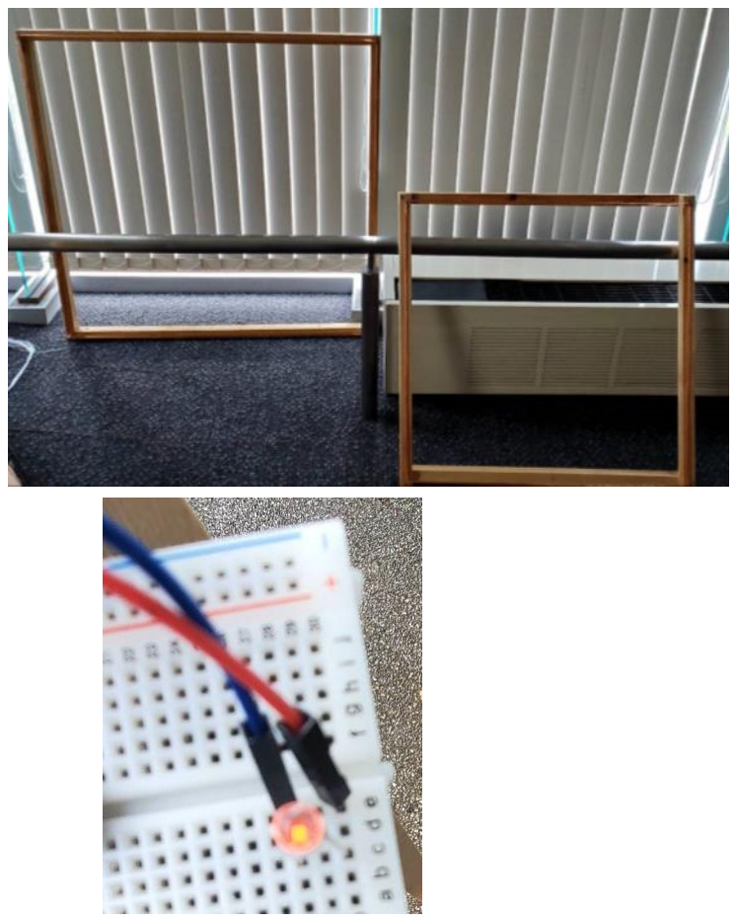
[picture p247: figure]
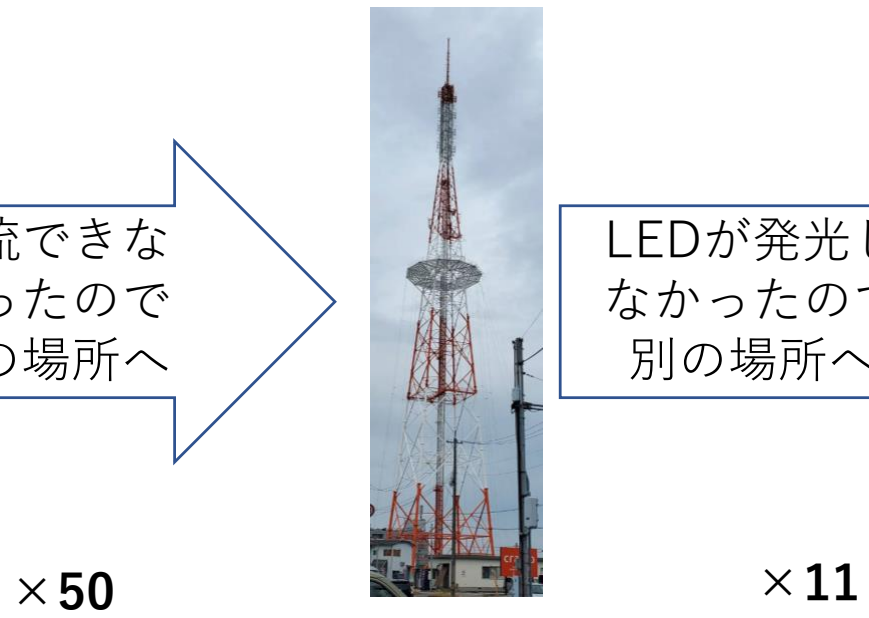
[picture p248: figure]
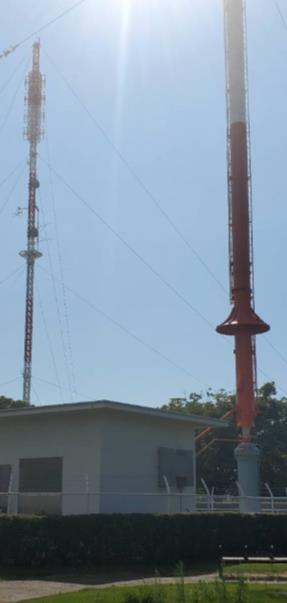
[picture p249: figure]
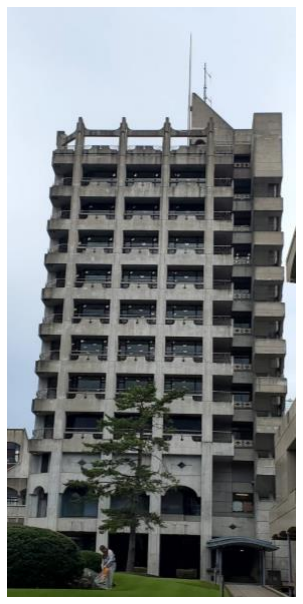
[picture p250: figure]

学内FMラジオ塔 | 4 (20w) | 学外FMラジオ塔(1kw) | 学外AMラジオ塔(10kw)+FMラジオ塔(1kw)

整流できな
かったので
別の場所へ

LEDが発光し
なかったので
別の場所へ

作成したアンテナ

## 実験内容(2/4) 太陽光発電との比較

- 4つアンテナを連結すると電池を充電できるだけの出力があったの で、太陽光パネルとアンテナで30分間づつ電地を充電し、発電量を 比べた。
- 電波での発電は日向では太陽光発電の実質 ¹
50 程度しか発電できない
が、太陽光発電が行えない程暗くても発電が可能であると分かった。

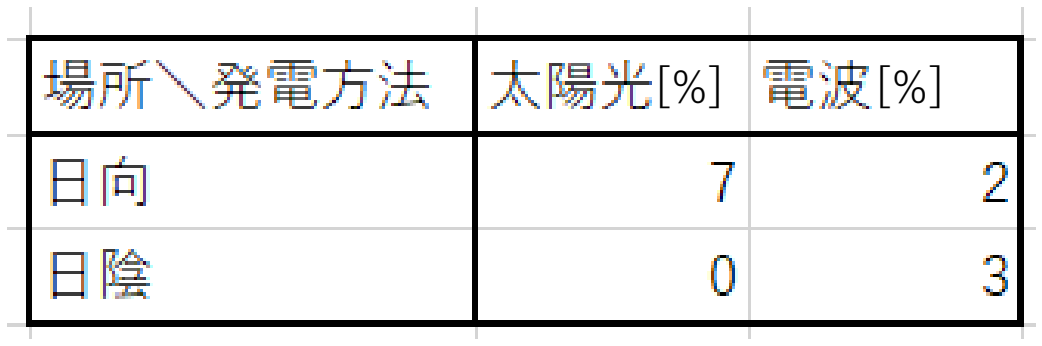
[picture p251: figure]

サイズ差を考慮しない時

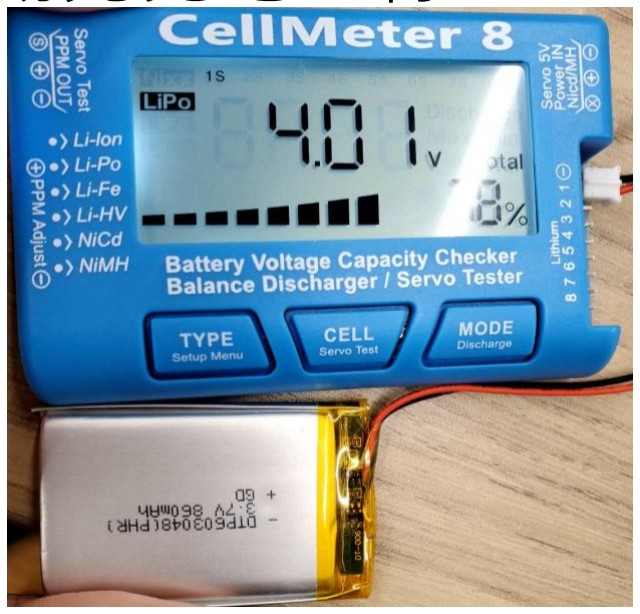
[picture p252: figure]

の発電方法と設置場所の 実験に用いた電池と電池 | 違いによる発電量の差 の残量を調べる機械

## 実験内容(3/4) 製作可能な電子機器を考える

- 電波から得られる電力は少ないので、電子機器は常時動作させ ず、スリープモードで動作を限定して充電に専念させ、短時間 だけ通常のモードで動作させることにした。
- 製作する電子機器は常時動作させる必要がない点や構造がシン プルで消費電力が少ない点から温度計にした。

アンテナ

ACDC変換器

## 実験内容(4/4) 電子機器の作成、実験

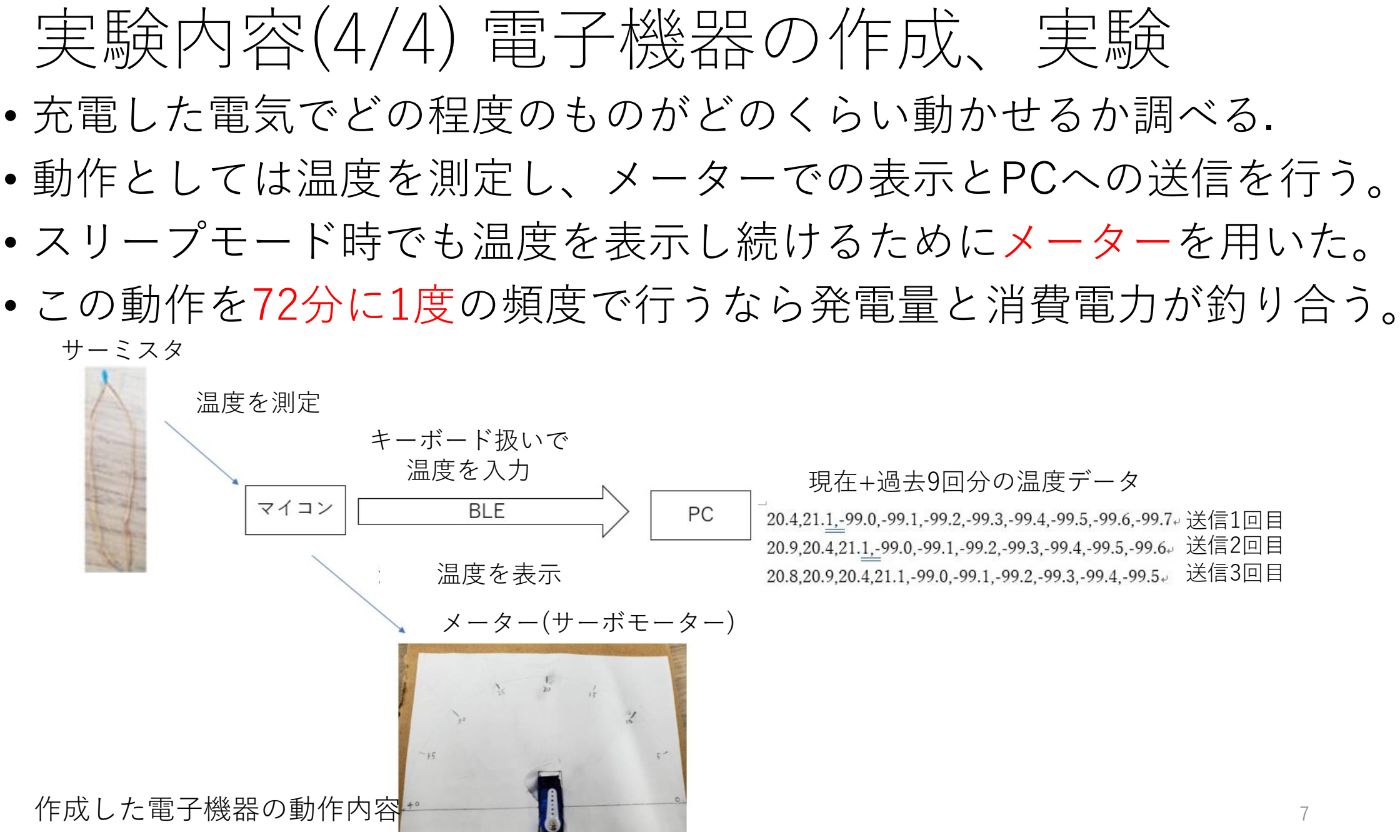
[picture p253: page 7]

- 充電した電気でどの程度のものがどのくらい動かせるか調べる.
- 動作としては温度を測定し、メーターでの表示とPCへの送信を行う。
- スリープモード時でも温度を表示し続けるためにメーターを用いた。
- この動作を72分に1度の頻度で行うなら発電量と消費電力が釣り合う。
作成した電子機器の動作内容 | 7

現在+過去9回分の温度データ

送信2回目

送信1回目

送信3回目

メーター(サーボモーター)

キーボード扱いで
温度を入力

温度を表示

温度を測定

サーミスタ

## 振り返り

- 電子機器の非電源化は成功したが、高出力のラジオ塔の半径50m 以内と言う極めて限定的な状況であり、太陽光発電のように設置 場所が制限される。

# 環境発電を用いた電子機器の 非電源化の実験

発表者:細川 蒼生

## 振り返り

- 電子機器の非電源化は成功したが、高出力のラジオ塔の半径50m 以内と言う極めて限定的な状況であり、太陽光発電のように設置 場所が制限される。

## 研究背景

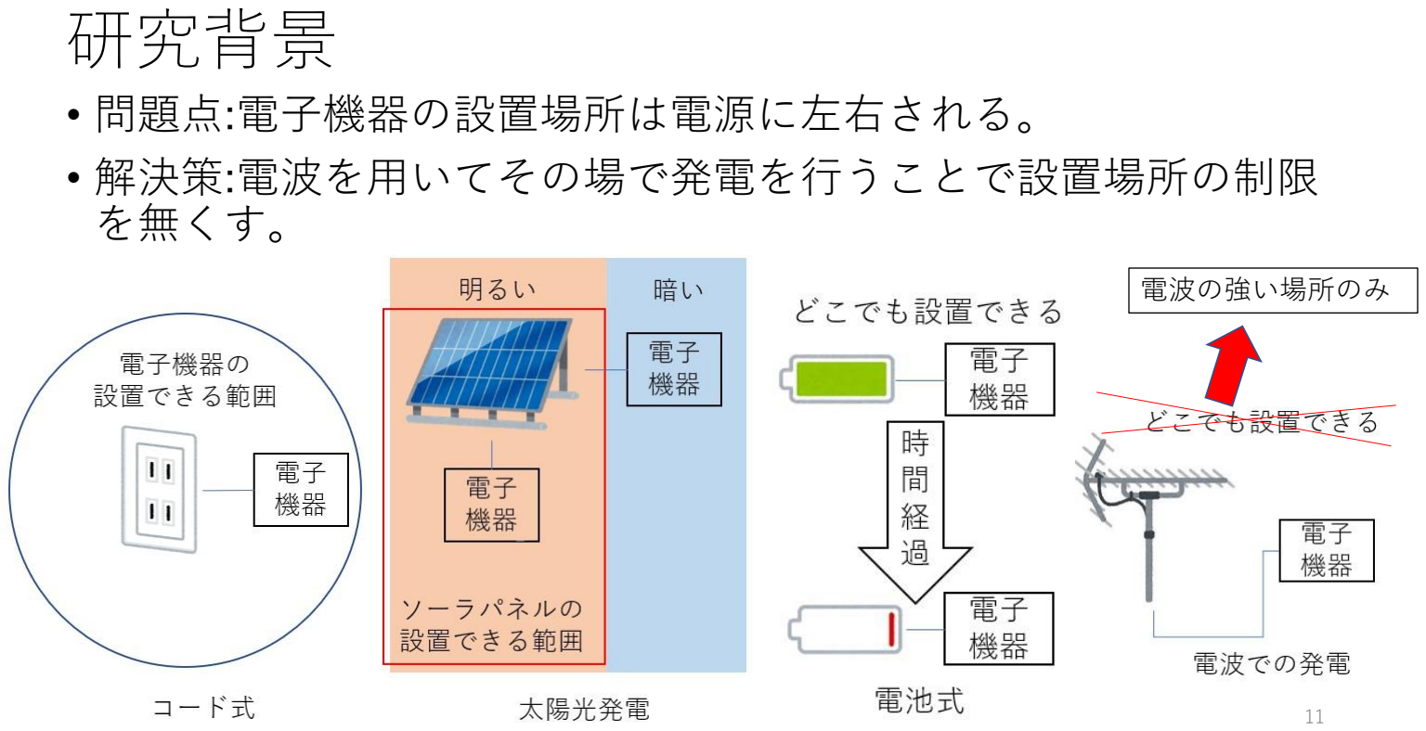
[picture p254: page 11]

- 問題点:電子機器の設置場所は電源に左右される。
- 解決策:電波を用いてその場で発電を行うことで設置場所の制限 を無くす。

電波の強い場所のみ

## 振り返り

- 電子機器の非電源化は成功したが、高出力のラジオ塔の半径50m 以内と言う極めて限定的な状況であり、太陽光発電のように設置 場所が制限される。
- ただし太陽光発電が行えない場所でも発電できることもあるので、 電子機器の設置場所の範囲は少し広がった。
- 発電を行う回路(アンテナや回路の部品)には妥協した部分がある ので、そこを変更するだけでも非電源化できる電子機器の種類や 電子機器の設置できる範囲は広げられると予想する。

## 参考文献

- 電波からエネルギーを取り出す研究
https://gakusyu.shizuoka-c.ed.jp/science/sonota/ronnbunshu/112005.pdf (https://gakusyu.shizuoka-c.ed.jp/science/sonota/ronnbunshu/112005.pdf)
- メンテナンスフリーのセンサーを実現するエネルギー・ハーベ スティング技術
https://www.fujitsu.com/downloads/JP/archive/imgjp/jmag/vol64-5/paper14.pdf (https://www.fujitsu.com/downloads/JP/archive/imgjp/jmag/vol64-5/paper14.pdf)
- 実教出版株式会社 電子回路 新訂版
