1002380/soturonn/資料/研究ワークシート発表(中間).pdf

# IoT機器の非電源化

発表者:4EP4-50 細川 蒼生

## テーマ決定の経緯

- 電子回路や通信について興味があった。
- 身の回りの僅かなエネルギーを集めて発電する環境発電に関心 があったので、その中でも電波によって発電する回路を研究す ることにした
- これだけでは情報工学らしさが不足するので、動作させる電子 機器をIoT機器とし、少ない電気でIoT機器を動かすためには何 が重要かも調べることにした

## 領域・キーワード

- IoT:システム全体
- 電子回路:発電用回路
- 電波:環境発電、通信
- 組み込みシステム:マイコン関係

## 動向調査(1/3)

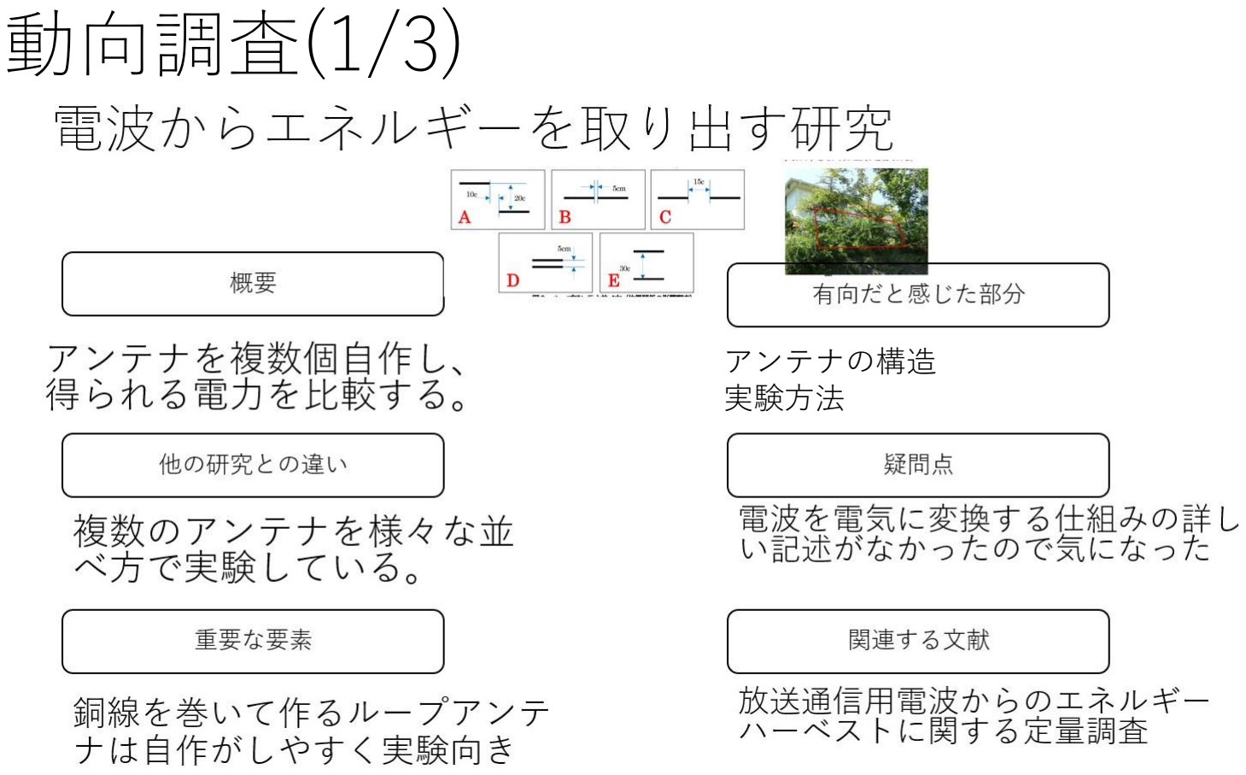
[picture p255: page 4]

アンテナの構造
実験方法

## 動向調査(2/3)

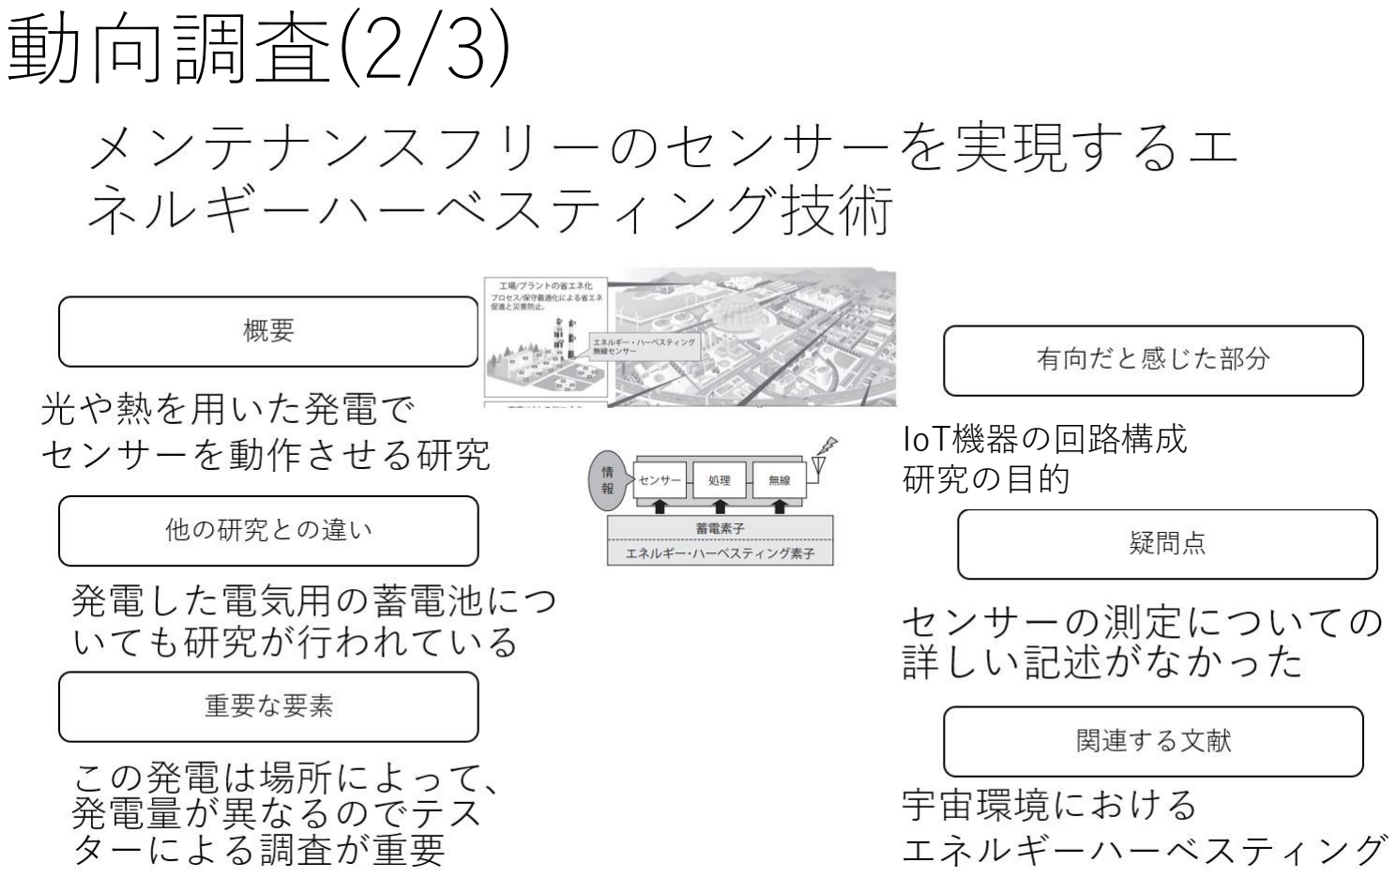
[picture p256: page 5]

IoT機器の回路構成
研究の目的

## 動向調査(3/3)

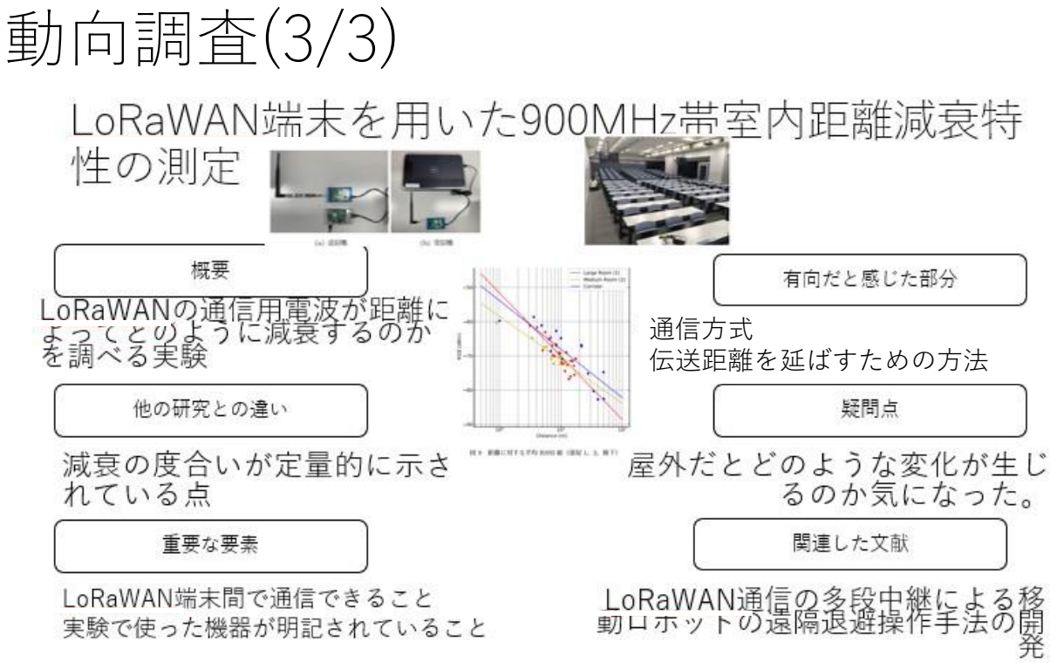
[picture p257: page 6]

通信方式
伝送距離を延ばすための方法

## シーズ・ニーズ

- 大体は動向調査(2/3)の研究を参考にしている。
- 問題点:IoT機器の設置場所は電源に左右される。
- 解決すべき課題:電池を使えばコンセントが無い場所でもIoT機 器を動かせられるが、稼働時間や回路の規模が制限される。
- トレードオフの解消:設置場所で発電を行うことで稼働時間等の 制限を無くす。
- 改善(新規性＆アイデア):発電用の電波にはFM波を使用する。 動向調査(1/3)の研究では回路構成はラジオをベースにしていた が、今回の研究ではACDC変換器をベースにしたものにする。
- 付加価値:電波さえあれば様々な場所に設置可能

対象

- IoT機器の置き場所に困っている人にとっては環境発電で動く IoT機器は設置場所の選定や電池交換の手間が省けるのでIoT機 器が扱いやすくなる。

## 評価指標と目標

- 発電量:5V1A以上
- 消費電力の少なさ:3~5V 数100mA
- 通信できる距離:200m~1000m
- 拡張性(ゆとり):どの程度のセンサやアクチュエータを搭載でき るか調べる

## レビュー(1/3)

- IoTシステムの画像

LoRaWAN
サーバ IoT機器 | コンピュータ Lora

①IoT機器が情報(温
度、照度等)を収集
する

②LoRa通信で
LoRaWAN用のゲート
ウェイへ情報を伝達
する

③インターネット経
由でIoT機器が収集
した情報をコン
ピュータに伝達する

学内ゲート
ウェイ

インター
ネット

インター
ネット

## レビュー(2/3)

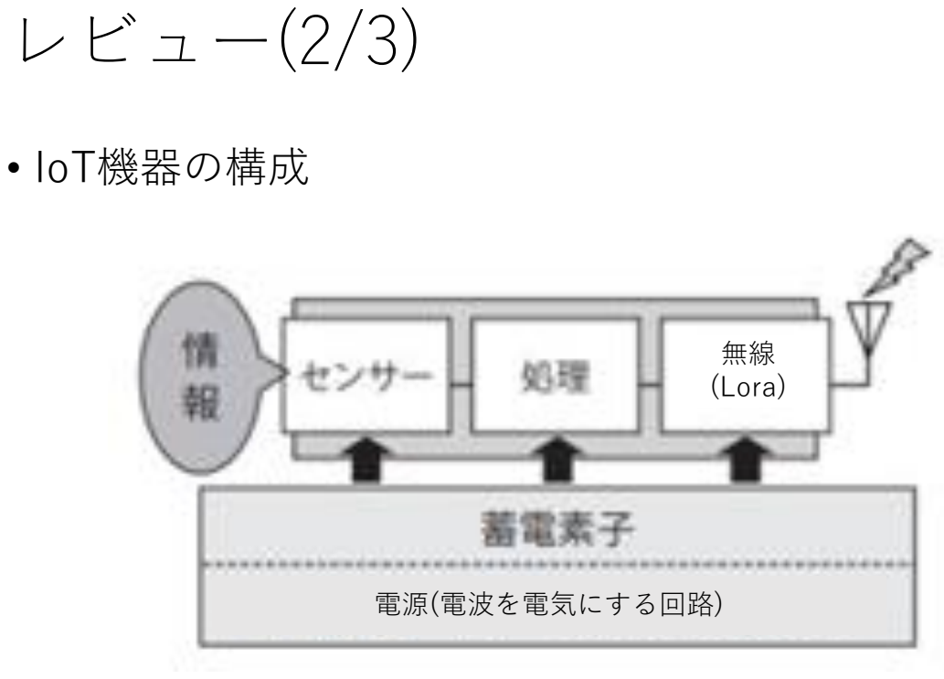
[picture p258: page 11]

- IoT機器の構成

電源(電波を電気にする回路)

無線
(Lora)

## レビュー(3/3)

- 電波を電気に変える仕組み

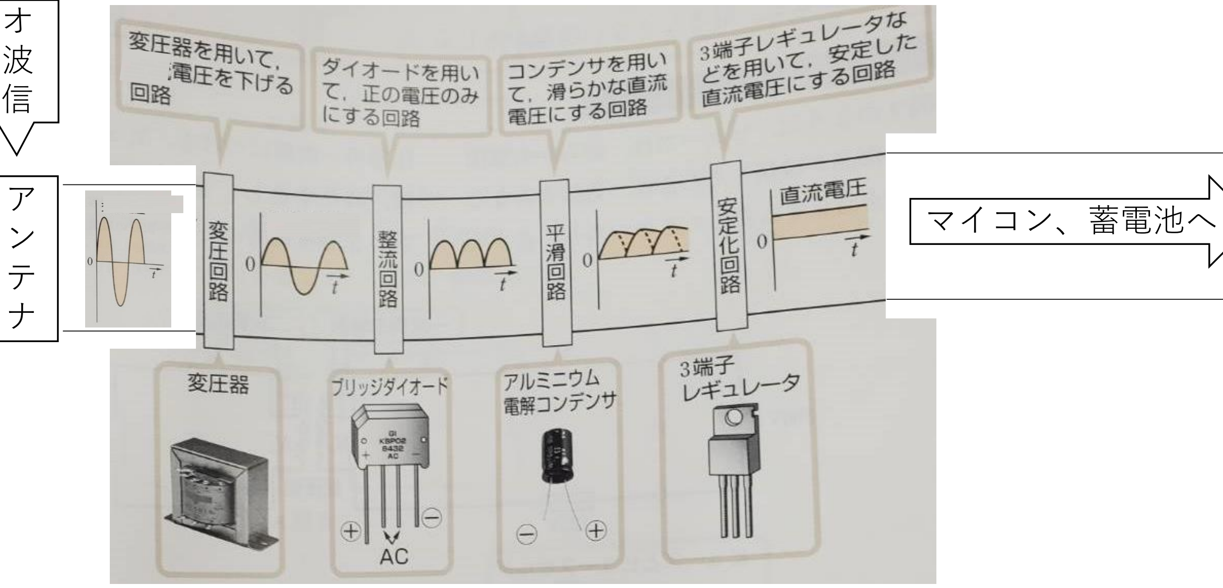
[picture p259: figure]
マイコン、蓄電池へ ア ン テ ナ

ラジオ
の電波
を受信

機能

- 利用する機能
- LoRaWAN:IoT機器の通信システム
- arduino及びarduino対応のセンサやアクチュエータ
- 開発する機能
- 環境発電用回路
- 必要なら通信用アンテナ

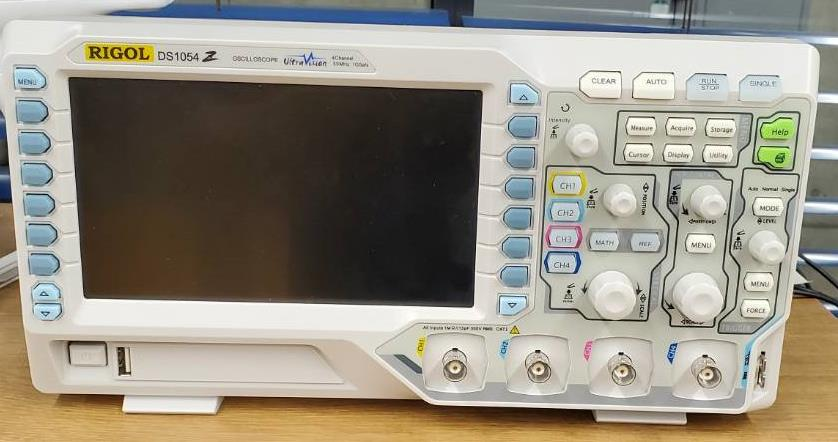
[picture p260: figure]

環境

- 開発環境
- Thonny(PC側プログラム作成)
- arduino IDE(マイコン側プログラム作成)
- 金沢工業大学(環境発電用回路作成)
- 実証実験環境
- オシロスコープ RIGOL DS1054
- 電流電圧計 SANWA CD771
- 評価環境
- Microsoft Office

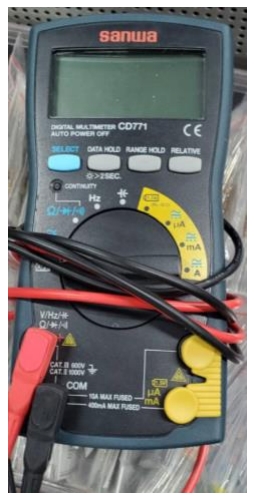
[picture p261: figure]

## 新規アイデアの実装方法

- プログラムコード

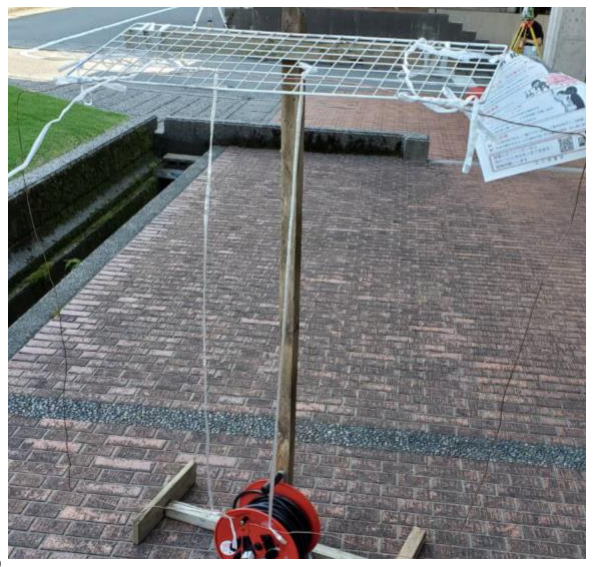
[picture p262: figure]

- lorawanの実習で使用したプログラムを流用する。
- 送信用プログラムは一部改変する可能性あり
- ハードウェア
- 銅線を加工し、発電用のアンテナを作成する。
- アンテナから得られた電気を直流の電気に変換する
ために、ACDC変換回路を作成する。

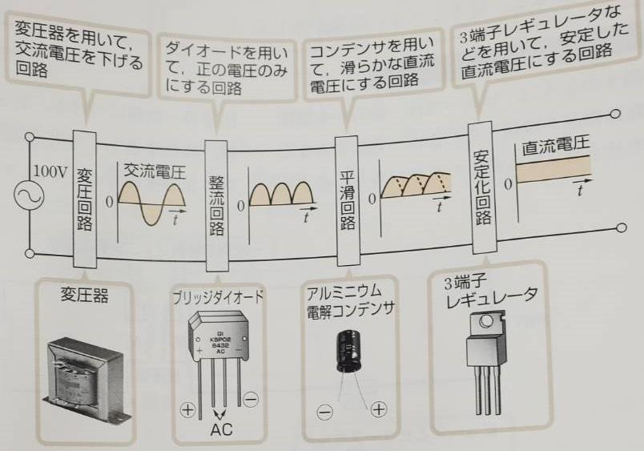
[picture p263: figure]

- マイコン関係のハードウェアは実習で用いたものを借りれるか を実習担当者に相談し、借りれないなら同型のものを購入する。

## 計画について

- 前学期
- 電波による発電のみでLEDを発光させる。(現状10%程度)
- 夏休み
- 発電効率を上げたり、IoT機器の消費電力を減らす方法を幾つか試す。
- 後学期
- 電波による発電のみでIoT機器を動作させる。
- IoT機器の動作に失敗した時にはどのような状況ならば動作が可能 かを考える。
- 卒論作成

## 評価方法(1/2)

- 発電量
- 幾つかのアンテナの作成し、製作コストや体積と発電量との比 率を求めて、効率の良いアンテナを調べる。
- 測定場所や測定時期を変更し、発電量にどのような影響がでる のかを調べる。
- 発電量の測定には電圧計を用いる。
- 消費電力の少なさ
- 消費電力を減らす改良を行い、改良前と改良後のマイコンの消 費電力の差からどれだけ消費電力を減らせたかを調べる。
- 消費電力の測定には電圧計を用いる。

## 評価方法(2/2)

- 通信できる距離
- 作成したIoT機器がどの程度まで通信ができるのか調べる。
- 通信用のアンテナも作成した場合には、それによって通信でき る距離がどのように変化したのか調べる。
- 拡張性(ゆとり)
- 幾つかのセンサやアクチュエータの消費電力を調べる。
- 発電量と消費電力の差からどの程度のセンサやアクチュエータ を追加する余裕があるのかを調べる。
- センサやアクチュエータの消費電力の測定には電圧計を用いる。

## レビュー

- 一つのアンテナから得られた電気だけでは、IoT機器を動作さ せることができない場合
→アンテナの数を増やす、IoT機器の動作時間を制限する、設置 場所を電波の発生元周辺に限定する。
- LoRaWANの担当教員からLoRa関係のサーバの使用が許可され ない場合
→LoRa通信対応のマイコン間でも設定次第で長距離通信が可能 なので、マイコンを2個買って片方をサーバの代わりにする

IoT機器
マイコンA

コンピュータ
Lora

サーバ代用
マイコンB

有線
