1002380/soturonn/資料/画像/画像4/画像4_8.jpg

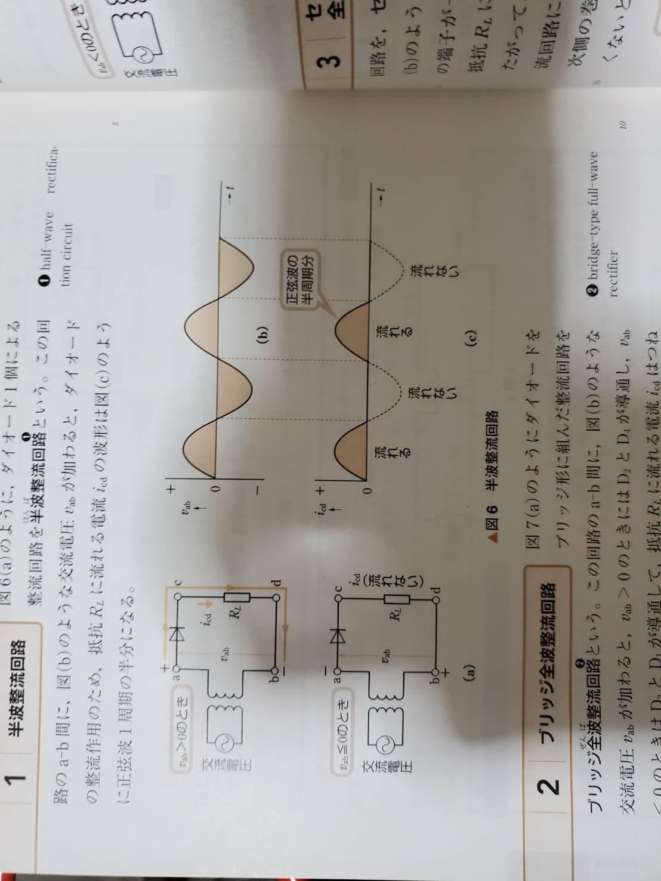
資料/画像/画像4/画像4_8.jpg
