1002380/soturonn/資料/画像/画像5/画像13.jpg

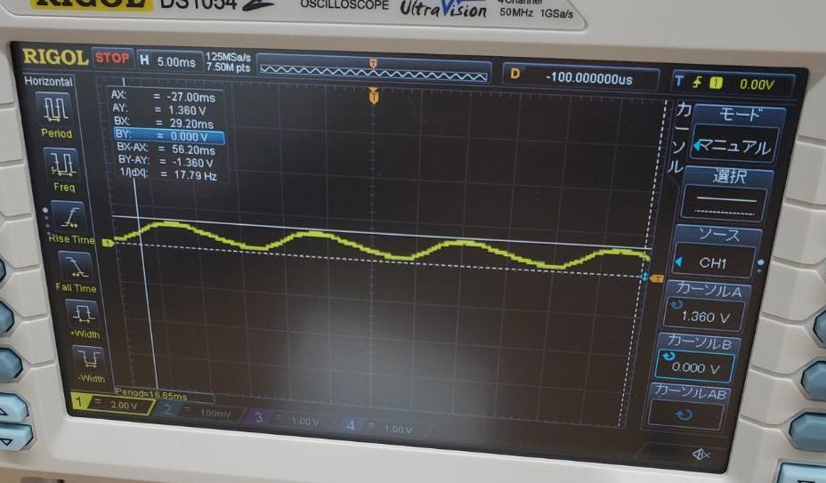
資料/画像/画像5/画像13.jpg
