1002380/soturonn/資料/画像/画像8/画像9_1.jpg

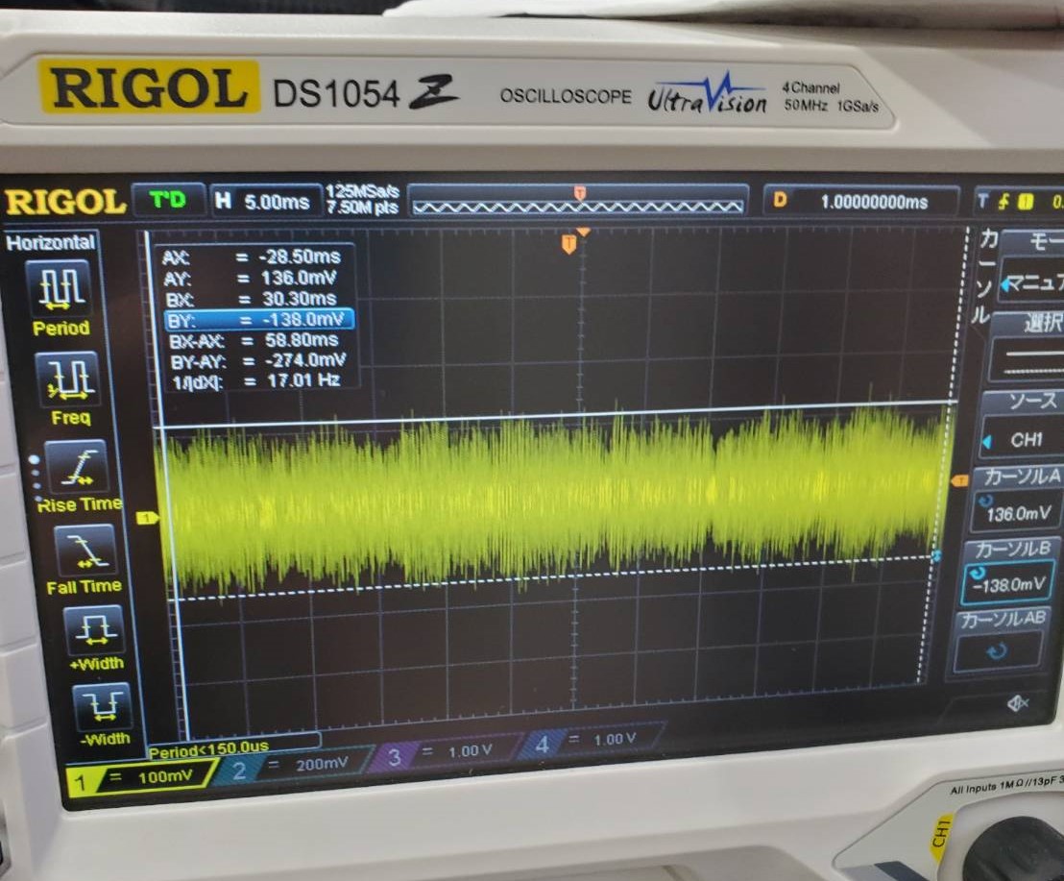
資料/画像/画像8/画像9_1.jpg
