1002380/soturonn/資料/画像/画像11/画像1.jpg

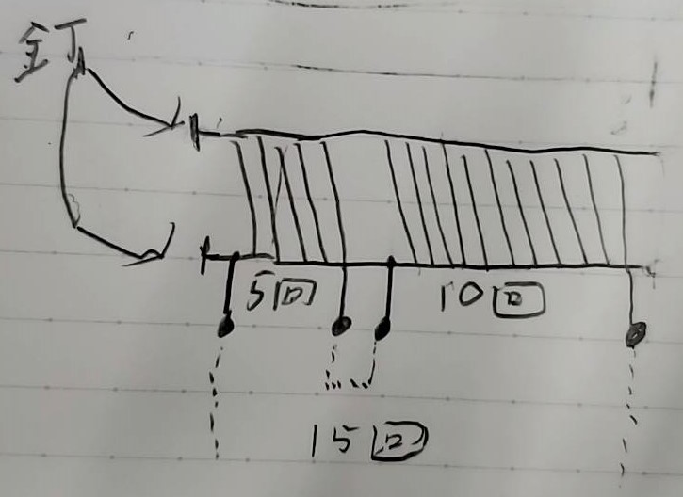
資料/画像/画像11/画像1.jpg
