1002380/soturonn/資料/画像/画像14/表2.jpg

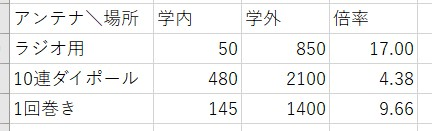
資料/画像/画像14/表2.jpg
