1002380/soturonn/資料/ポスター_細川.pdf

## 電波による電子機器の非電源化の研究

研究背景 | 評価内容

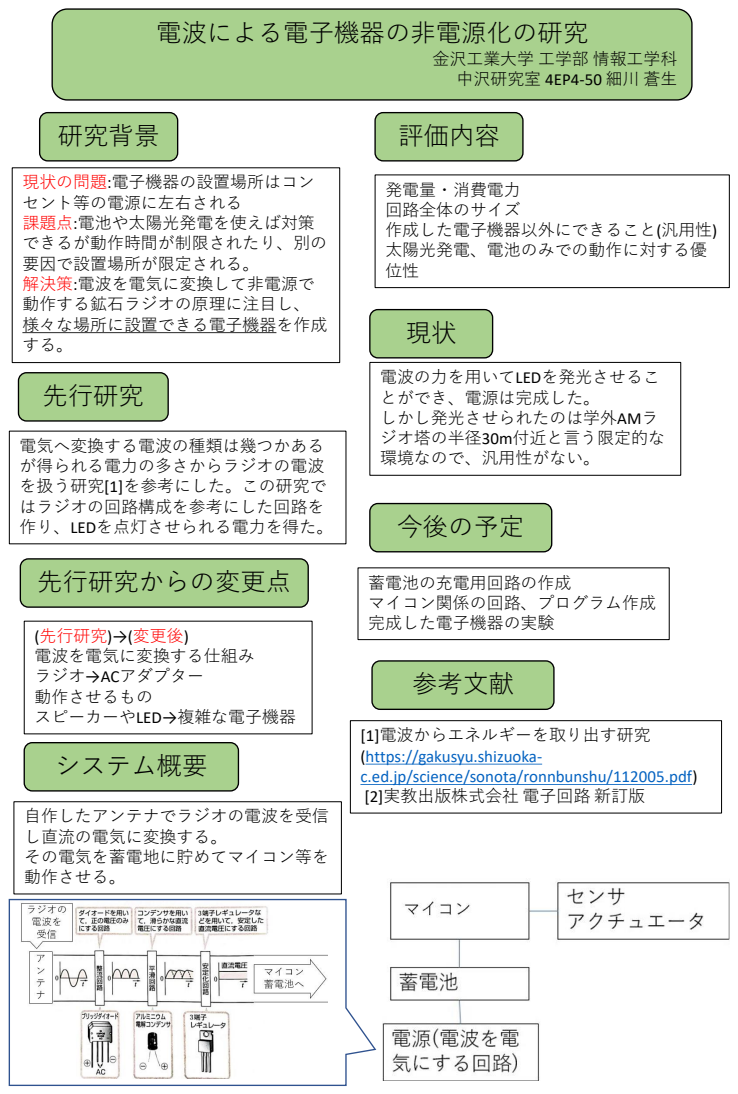
[picture p272: page 1]
システム概要; 現状の問題:電子機器の設置場所はコン セント等の電源に左右される 課題点:電池や太陽光発電を使えば対策 できるが動作時間が制限されたり、別の 要因で設置場所が限定される。 解決策:電波を電気に変換して非電源で 動作する鉱石ラジオの原理に注目し、 様々な場所に設置できる電子機器を作成 する。; 自作したアンテナでラジオの電波を受信 し直流の電気に変換する。 その電気を蓄電地に貯めてマイコン等を 動作させる。; 発電量・消費電力 回路全体のサイズ 作成した電子機器以外にできること(汎用性) 太陽光発電、電池のみでの動作に対する優 位性; 先行研究; 先行研究からの変更点; (先行研究)→(変更後) 電波を電気に変換する仕組み ラジオ→ACアダプター 動作させるもの スピーカーやLED→複雑な電子機器; 今後の予定; 電波の力を用いてLEDを発光させるこ とができ、電源は完成した。 しかし発光させられたのは学外AMラ ジオ塔の半径30m付近と言う限定的な 環境なので、汎用性がない。; 蓄電池の充電用回路の作成 マイコン関係の回路、プログラム作成 完成した電子機器の実験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

金沢工業大学 工学部 情報工学科
中沢研究室 4EP4-50 細川 蒼生

電気へ変換する電波の種類は幾つかある
が得られる電力の多さからラジオの電波
を扱う研究[1]を参考にした。この研究で
はラジオの回路構成を参考にした回路を
作り、LEDを点灯させられる電力を得た。

[1]電波からエネルギーを取り出す研究
(https://gakusyu.shizuoka-
c.ed.jp/science/sonota/ronnbunshu/112005.pdf) (https://gakusyu.shizuoka-c.ed.jp/science/sonota/ronnbunshu/112005.pdf)
[2]実教出版株式会社 電子回路 新訂版
